monome/aleph-hardware/README.md

aleph-hardware
==============

http://monome.org/aleph

see license.txt
cc-by-sa

all circuit and board files created using cadsoft eagle.
