monome/aleph-hardware/aleph-bom.ods

 | aleph partlist
 | part number | supplier pn | supplier | qty required | comment | sch part
120 | ADSP-BF533SKSTZ-5V | ADSP-BF533SKSTZ-5V-ND | analog | 1 | dsp | DSP1
112 | AT32UC3A0512-ALTTA | AT32UC3A0512-ALTTA-ND | dk | 1 | controller | U15
112 | AD1939YSTZ | AD1939YSTZ-ND | dk | 1 | audio codec | U17
112 | MT48LC32M16A2TG-75:C TR | 557-1080-1-ND | dk | 1 | sdram for dsp | U23
112 | CY62157EV30LL-45ZXI | CY62157EV30LL-45ZXI | arrow | 1 | sram for controller | U16
1700 | AD8606ARZ | AD8606ARZ | avnet | 15 | audio opamp | IC2-IC13
112 | TPS2020D | 296-2560-5-ND | dk | 1 | controller host usb power switch | U4
112 | AD5686RARUZ | AD5686RARUZ-ND | dk | 1 | dac quad 16-bit, dsp cv out | U24
112 | AD7923BRUZ-REEL7 | AD7923BRUZ-REEL7CT-ND | avnet | 1 | adc quad cv controller | U21
112 | FDS9431A | FDS9431ACT-ND | ms | 1 | dsp power mosfet | U10
112 | LM2678SX-5.0/NOPB | LM2678SX-5.0/NOPBCT-ND | dk | 1 | main power regulator | U5
250 | ADP3339AKCZ-3.3-R7 | ADP3339AKCZ-3.3-R7CT-ND | dk | 2 | 3.3v regulator | U7, U9
112 | MSS1278-153ML_ | MSS1278-153ML_ | coilcraft | 1 | main power coil | L4
120 | SRR6038-100Y | SRR6038-100YCT-ND | dk | 1 | dsp power coil | L8
250 | MBRS360T3G | MBRS360T3GOSCT-ND | dk | 2 | main power diode | D13, D14
112 | ASFL1-27.000MHZ-L-T | 535-10820-2-ND | dk | 1 | dsp osc | Y1
112 | ASFL1-12.288MHZ-L-T | 535-10810-1-ND | dk | 1 | codec osc | Y3
112 | ECS-120-18-5PX-TR | XC1289CT-ND | ms | 1 | controller xtal | Y2
112 | LM4040D25IDBZR | 296-17940-1-ND | dk | 1 | controller ADC vref | U22
112 | ZHCS1000TA | ZHCS1000CT-ND | dk | 1 | dsp power diode | D2
112 | 2041021-3 | 35R2925 | tti | 1 | sdcard slot | S1
401 | EM14A0D-C24-L064N | EM14A0D-C24-L064N-ND | dk | 4 | encoder | E1-E4
110 | NHD-2.7-12864UCY3 | NHD-2.7-12864UCY3 | newhaven | 1 | oled screen
112 | SN74LVC2G14DBVR | 296-13010-1-ND | ms | 1 | inverter dual, debouncing | U26
112 | SN74AHCT14D | 296-1474-1-ND | avnet | 1 | inverter hex, debouncing | U25
112 | AD8567ARUZ-REEL | AD8567ARUZ-REELCT-ND | avnet | 1 | op amp, cv out gain | IC1
3000 | 1N4148W-TP | 833-1N4148W-TP | ms | 6 | diodes | D7-D12
112 | ATMEGA32U4-AUR | ATMEGA32U4-AURDKR-ND | dk | 1 | avr for usb-uart | U6
1000 | BAS70-04-E3-08 | BAS70-04-E3-08DKR-ND | ms | 6 | protection diodes | U1, U3, U11-U14
112 | LMR62014XMF/NOPB | LMR62014XMF/NOPBDKR-ND | dk | 1 | power boost converter, 12V system | U2
250 | MBR0520L-TP | MBR0520L-TPMSDKR-ND | dk | 1 | diode for 12V | D1
112 | EVQ-PNF04M | P13597SDKR-ND | ms | 1 | controller reset sw | SW1
112 | TPA6111A2DR | 296-10846-6-ND | ms | 1 | headphone amp | U8
120 | XAL7030-103 | XAL7030-103 | coilcraft | 1 | coil for 12V | L1
112 | NX5032GB-16MHZ-STD-CSK-5 | 644-1192-6-ND | dk | 1 | xtal for avr usb bridge | X1
500 | MMZ1608B601C | 445-2166-1-ND | dk | 4 | ADC filter | L6, L7, L9, L10
500 | LW Q38E-Q1S2-3K6L-1 | 475-2831-6-ND | ms | 5 | white led | LED3, LED4, LED6, LED8
350 | LTST-C170KRKT | 160-1415-6-ND | dk | 3 | red led | LED5, LED7, LED12
 | T491A475K016AT | 399-3697-2-ND | dk | 6 | cap 4.7u tant 1206
 | T491A106K010AT | 399-3684-2-ND | dk | 36 | cap 10u tant 1206
 | T491A226K010AT | 399-8280-2-ND | dk | 1 | cap 22u tant 1206
 | T491A476M006AT | 399-3700-1-ND | dk | 1 | cap 47u tant 1206
 | T491A686K006AT | 399-4698-2-ND | dk | 2 | cap 68u tant 1206
 | TAJB107M010RNJ | 478-5801-2-ND | dk | 2 | cap 100u tant 1210
 | T495C226K016ZTE350 | 495-1540-2-ND | dk | 1 | cap 22u tant 6032 (power in)
 | T495L107K010ZTE180 | 399-5193-2-ND | dk | 2 | cap 100u tant 7374 (power out)
 | C1608C0G1H080D080AA | 445-5043-2-ND | dk | 2 | cap 8p 0603
 | C1608C0G1H220J080AA | 445-1273-2-ND | dk | 2 | cap 22p 0603
 | C1608C0G1H101J080AA | 445-1281-2-ND | dk | 18 | cap 100p 0603
 | C0603C121J5GACTU | 399-1062-2-ND | dk | 8 | cap 120p 0603
 | CL10C221JB8NNNC | 1276-1048-2-ND | dk | 5 | cap 220p 0603
 | CL10C331JB8NNNC | 1276-1073-2-ND | dk | 4 | cap 330p 0603
 | CC0603KRX7R9BB391 | 311-1187-2-ND | dk | 1 | cap 390p 0603
 | CL10C471JB8NCNC | 1276-2302-2-ND | dk | 1 | cap 470p 0603
 | C1608X7R1H681K | 445-5077-2-ND | dk | 1 | cap 680p 0603
 | CL10B102KB8NNNC | 1276-1018-2-ND | dk | 8 | cap 1n 0603
 | CL10B222KB8SFNC | 1276-1992-2-ND | dk | 4 | cap 2.2n 0603
 | CL10B272KB8SFNC | 1276-2023-2-ND | dk | 5 | Cap 2.7n 0603
 | CL10B562KB8SFNC | 1276-2092-2-ND | dk | 1 | Cap 5.6n 0603
 | CL10B333KB8SFNC | 1276-2042-1-ND | dk | 11 | cap 33n 0603
 | CC0603ZRY5V9BB104 | 311-1343-2-ND | dk | 61 | cap 100n 0603
 | UMK107BJ105KA-T | 587-2400-2-ND | dk | 12 | cap 1u 0603
 | RC0603JR-070RL | 311-0.0GRTR-ND | dk | 15 | res 0 0603
 | RC0603JR-0722RL | 311-22GRTR-ND | dk | 3 | Res 22 0603
 | RC0603JR-0733RL | 311-33GRTR-ND | dk | 2 | Res 33 0603
 | RC0603JR-0739RL | 311-39GRTR-ND | dk | 2 | Res 39 0603
 | RC0603FR-07120RL | 311-120HRTR-ND | dk | 6 | Res 120 0603
 | RC0603FR-07150RL | 311-150HRTR-ND | dk | 4 | Res 150 0603
 | RC0603FR-07237RL | 311-237HRTR-ND | dk | 8 | Res 237 0603
 | RC0603FR-07270RL | 311-270HRTR-ND | dk | 8 | Res 270 0603
 | RC0603FR-07562RL | 311-562HRTR-ND | dk | 1 | Res 562 0603
 | RC0603FR-07604RL | 311-604HRTR-ND | dk | 4 | Res 604 0603
 | RC0603JR-071KL | 311-1.0KGRTR-ND | dk | 4 | Res 1.0k 0603
 | RC0603FR-071K65L | 311-1.65KHRTR-ND | dk | 4 | Res 1.65k 0603
 | RC0603FR-072K74L | 311-2.74KHRTR-ND | dk | 4 | Res 2.74k 0603
 | RC0603FR-073K32L | 311-3.32KHRTR-ND | dk | 5 | Res 3.32k 0603
 | RC0603JR-074K7L | 311-4.7KGRTR-ND | dk | 6 | Res 4.7k 0603
 | RC0603FR-075K49L | 311-5.49KHRTR-ND | dk | 8 | Res 5.49k 0603
 | RC0603FR-075K76L | 311-5.76KHRTR-ND | dk | 16 | Res 5.76k 0603 !
 | RC0603JR-0710KL | 311-10KGRTR-ND | dk | 28 | res 10k 0603 !
 | RC0603FR-0711KL | 311-11.0KHRTR-ND | dk | 4 | res 11k 0603
 | RC0603FR-0713K3L | 311-13.3KHRTR-ND | dk | 1 | Res 13.3k 0603
 | RC0603FR-0718KL | 311-18.0KHRTR-ND | dk | 15 | res 18k 0603
 | RC0603FR-0720KL | 311-20.0KHRTR-ND | dk | 2 | res 20k 0603
 | RC0603FR-0747KL | 311-47.0KHRTR-ND | dk | 7 | res 47k 0603
 | RC0603FR-0749K9L | 311-49.9KHRTR-ND | dk | 4 | Res 49.9k 0603
 | RC0603JR-0756KL | 311-56KGRTR-ND | dk | 2 | res 56k 0603
 | RC0603FR-07100KL | 311-100KHRTR-ND | dk | 17 | res 100k 0603
 | RC0603FR-07118KL | 311-118KHRTR-ND | dk | 1 | res 118k 0603
 | RC0603FR-07470KL | 311-470KHRTR-ND | dk | 5 | res 470k 0603
 | RC0603FR-07750KL | 311-750KHRTR-ND | dk | 4 | res 750k 0603
