monome/aleph-hardware/eagle/aleph.brd

## EAGLE design eagle/aleph.brd (2014-03-25)

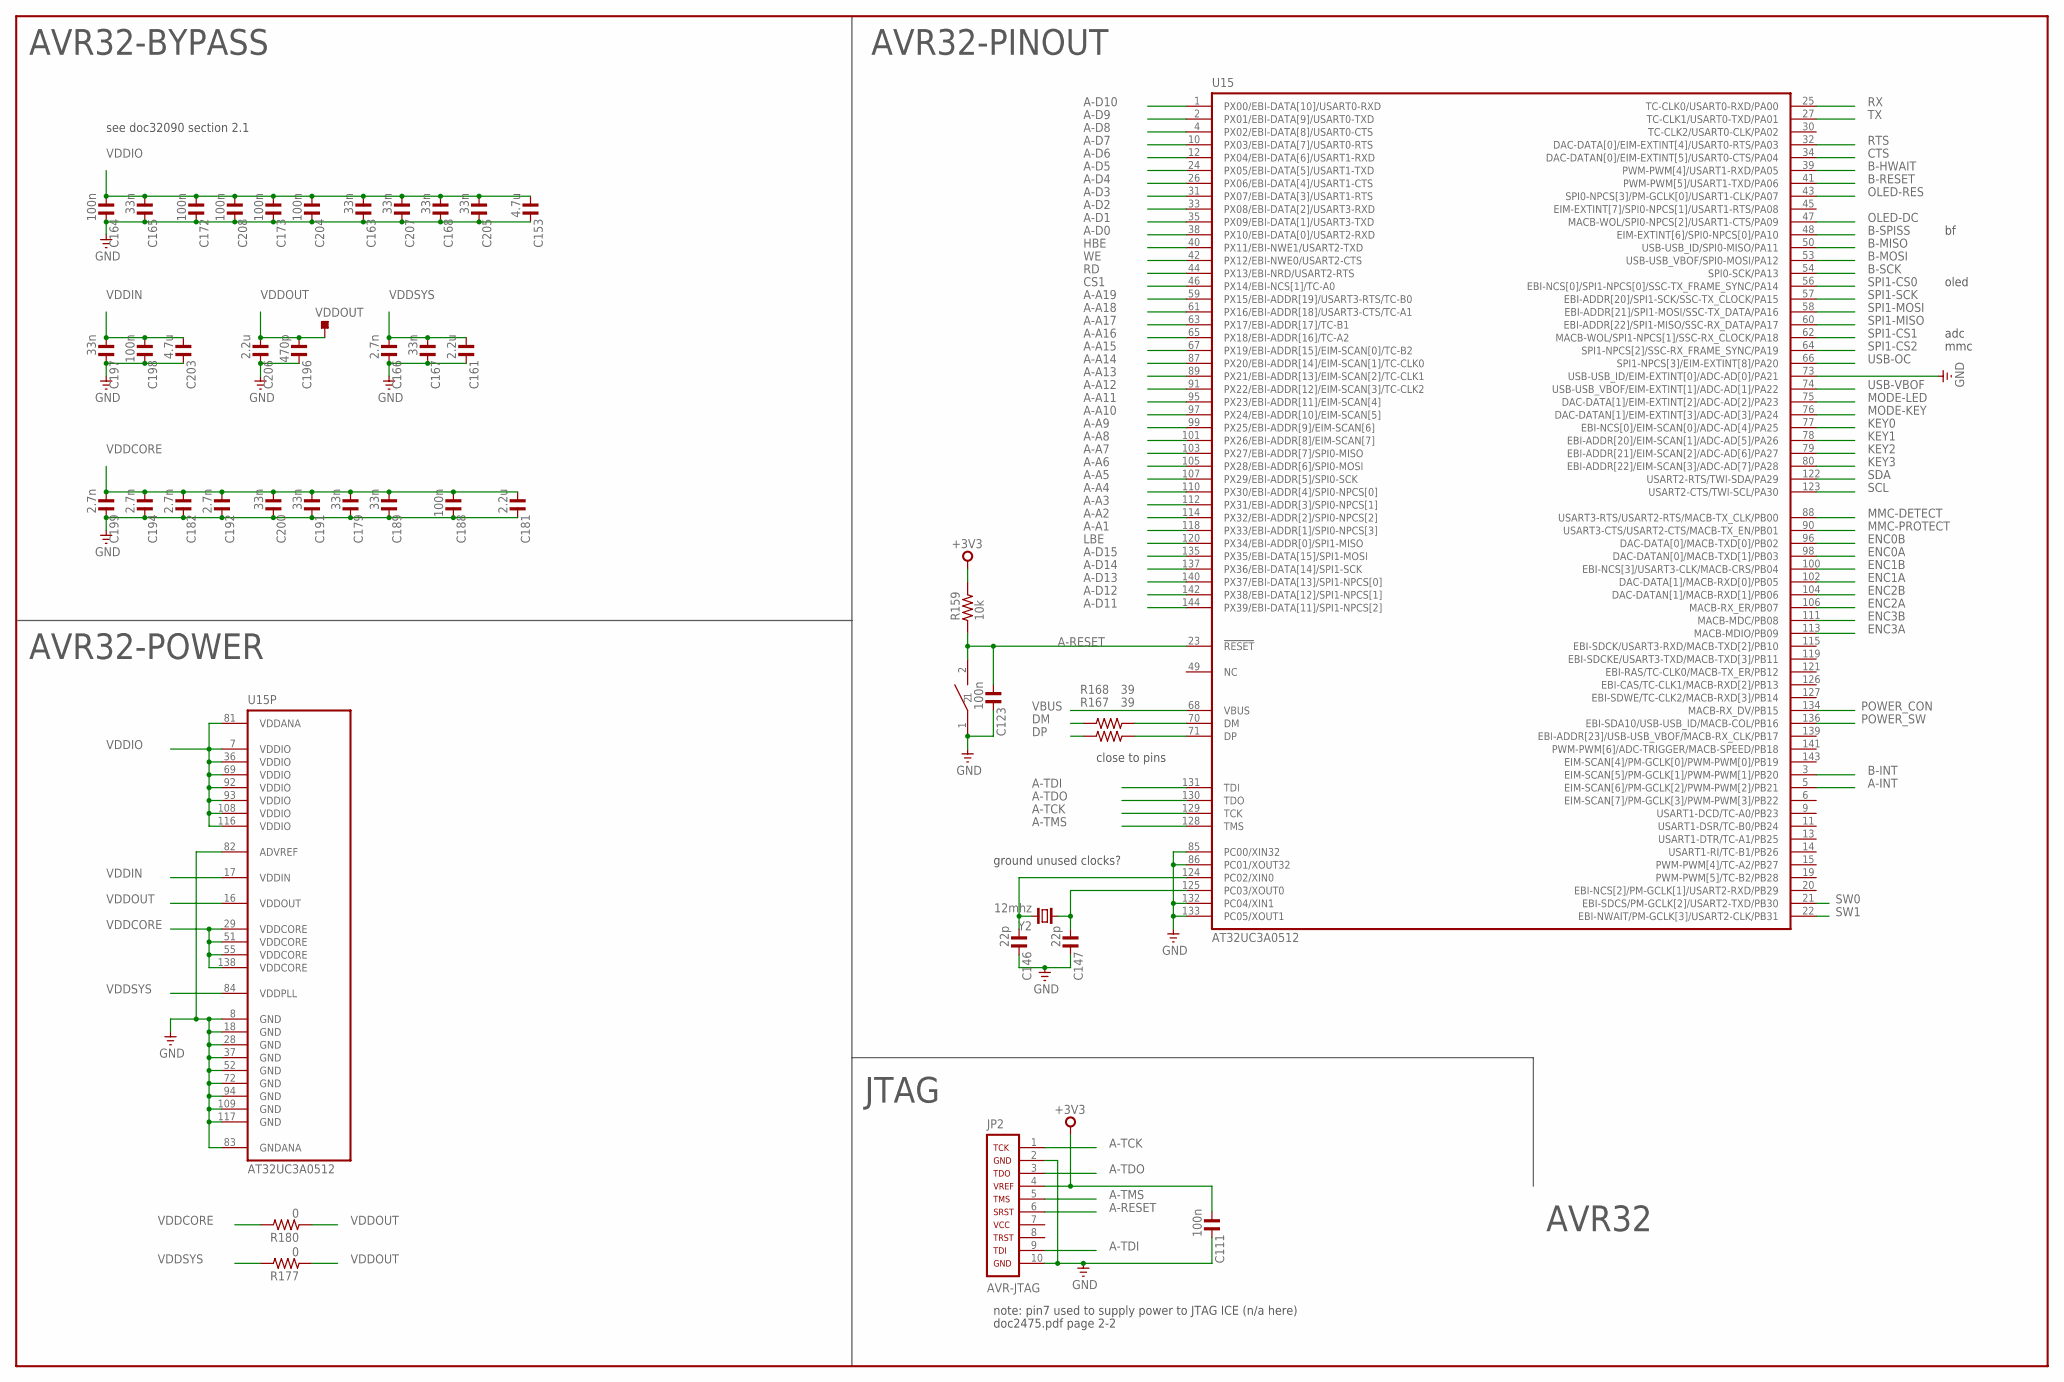
[picture p10: schematic aleph.sch, sheet 1]

Parts:
C111, C123, C164, C172, C173, C188, C198, C204, C208: 100n; C0603
C146, C147: 22p; C0603
C153, C203: 4.7u; C1206
C161, C181, C206: 2.2u; C1206
C163, C165, C167, C168, C179, C189, C191, C197, C200, C205, C207: 33n; C0603
C166, C182, C192, C194, C199: 2.7n; C0603
C196: 470p; C0603
JP2: AVR-JTAG; AVR-JTAG-10
R159: 10k; R0603
R167, R168: 39; R0603
R177, R180: 0; R0603
SW1: PANASONIC-EVQ
U15: AT32UC3A0512; LQFP144
VDDOUT: TPS-SMD-10R; SMD-10R
Y2: 12mhz; HC49UP

Connections:
+3V3: C111.1, JP2.4, R159.2; also elsewhere on the board
A-A1: U15.118 (PX33/EBI-ADDR[1]/SPI0-NPCS[3]); also elsewhere on the board
A-A2: U15.114 (PX32/EBI-ADDR[2]/SPI0-NPCS[2]); also elsewhere on the board
A-A3: U15.112 (PX31/EBI-ADDR[3]/SPI0-NPCS[1]); also elsewhere on the board
A-A4: U15.110 (PX30/EBI-ADDR[4]/SPI0-NPCS[0]); also elsewhere on the board
A-A5: U15.107 (PX29/EBI-ADDR[5]/SPI0-SCK); also elsewhere on the board
A-A6: U15.105 (PX28/EBI-ADDR[6]/SPI0-MOSI); also elsewhere on the board
A-A7: U15.103 (PX27/EBI-ADDR[7]/SPI0-MISO); also elsewhere on the board
A-A8: U15.101 (PX26/EBI-ADDR[8]/EIM-SCAN[7]); also elsewhere on the board
A-A9: U15.99 (PX25/EBI-ADDR[9]/EIM-SCAN[6]); also elsewhere on the board
A-A10: U15.97 (PX24/EBI-ADDR[10]/EIM-SCAN[5]); also elsewhere on the board
A-A11: U15.95 (PX23/EBI-ADDR[11]/EIM-SCAN[4]); also elsewhere on the board
A-A12: U15.91 (PX22/EBI-ADDR[12]/EIM-SCAN[3]/TC-CLK2); also elsewhere on the board
A-A13: U15.89 (PX21/EBI-ADDR[13]/EIM-SCAN[2]/TC-CLK1); also elsewhere on the board
A-A14: U15.87 (PX20/EBI-ADDR[14]/EIM-SCAN[1]/TC-CLK0); also elsewhere on the board
A-A15: U15.67 (PX19/EBI-ADDR[15]/EIM-SCAN[0]/TC-B2); also elsewhere on the board
A-A16: U15.65 (PX18/EBI-ADDR[16]/TC-A2); also elsewhere on the board
A-A17: U15.63 (PX17/EBI-ADDR[17]/TC-B1); also elsewhere on the board
A-A18: U15.61 (PX16/EBI-ADDR[18]/USART3-CTS/TC-A1); also elsewhere on the board
A-A19: U15.59 (PX15/EBI-ADDR[19]/USART3-RTS/TC-B0); also elsewhere on the board
A-D0: U15.38 (PX10/EBI-DATA[0]/USART2-RXD); also elsewhere on the board
A-D1: U15.35 (PX09/EBI-DATA[1]/USART3-TXD); also elsewhere on the board
A-D2: U15.33 (PX08/EBI-DATA[2]/USART3-RXD); also elsewhere on the board
A-D3: U15.31 (PX07/EBI-DATA[3]/USART1-RTS); also elsewhere on the board
A-D4: U15.26 (PX06/EBI-DATA[4]/USART1-CTS); also elsewhere on the board
A-D5: U15.24 (PX05/EBI-DATA[5]/USART1-TXD); also elsewhere on the board
A-D6: U15.12 (PX04/EBI-DATA[6]/USART1-RXD); also elsewhere on the board
A-D7: U15.10 (PX03/EBI-DATA[7]/USART0-RTS); also elsewhere on the board
A-D8: U15.4 (PX02/EBI-DATA[8]/USART0-CTS); also elsewhere on the board
A-D9: U15.2 (PX01/EBI-DATA[9]/USART0-TXD); also elsewhere on the board
A-D10: U15.1 (PX00/EBI-DATA[10]/USART0-RXD); also elsewhere on the board
A-D11: U15.144 (PX39/EBI-DATA[11]/SPI1-NPCS[2]); also elsewhere on the board
A-D12: U15.142 (PX38/EBI-DATA[12]/SPI1-NPCS[1]); also elsewhere on the board
A-D13: U15.140 (PX37/EBI-DATA[13]/SPI1-NPCS[0]); also elsewhere on the board
A-D14: U15.137 (PX36/EBI-DATA[14]/SPI1-SCK); also elsewhere on the board
A-D15: U15.135 (PX35/EBI-DATA[15]/SPI1-MOSI); also elsewhere on the board
A-INT: U15.5 (EIM-SCAN[6]/PM-GCLK[2]/PWM-PWM[2]/PB21); also elsewhere on the board
A-RESET: C123.1, JP2.6, R159.1, SW1.2, U15.23 (!RESET)
A-TCK: JP2.1, U15.129 (TCK)
A-TDI: JP2.9, U15.131 (TDI)
A-TDO: JP2.3, U15.130 (TDO)
A-TMS: JP2.5, U15.128 (TMS)
B-HWAIT: U15.39 (PWM-PWM[4]/USART1-RXD/PA05); also elsewhere on the board
B-INT: U15.3 (EIM-SCAN[5]/PM-GCLK[1]/PWM-PWM[1]/PB20); also elsewhere on the board
B-MISO: U15.50 (USB-USB_ID/SPI0-MISO/PA11); also elsewhere on the board
B-MOSI: U15.53 (USB-USB_VBOF/SPI0-MOSI/PA12); also elsewhere on the board
B-RESET: U15.41 (PWM-PWM[5]/USART1-TXD/PA06); also elsewhere on the board
B-SCK: U15.54 (SPI0-SCK/PA13); also elsewhere on the board
B-SPISS: U15.48 (EIM-EXTINT[6]/SPI0-NPCS[0]/PA10); also elsewhere on the board
CS1: U15.46 (PX14/EBI-NCS[1]/TC-A0); also elsewhere on the board
CTS: U15.34 (DAC-DATAN[0]/EIM-EXTINT[5]/USART0-CTS/P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); also elsewhere on the board
DM: R168.2; also elsewhere on the board
DP: R167.2; also elsewhere on the board
ENC0A: U15.98 (DAC-DATAN[0]/MACB-TXD[1]/PB03); also elsewhere on the board
ENC0B: U15.96 (DAC-DATA[0]/MACB-TXD[0]/PB02); also elsewhere on the board
ENC1A: U15.102 (DAC-DATA[1]/MACB-RXD[0]/PB05); also elsewhere on the board
ENC1B: U15.100 (EBI-NCS[3]/USART3-CLK/MACB-CRS/PB04); also elsewhere on the board
ENC2A: U15.106 (MACB-RX_ER/PB07); also elsewhere on the board
ENC2B: U15.104 (DAC-DATAN[1]/MACB-RXD[1]/PB06); also elsewhere on the board
ENC3A: U15.113 (MACB-MDIO/PB09); also elsewhere on the board
ENC3B: U15.111 (MACB-MDC/PB08); also elsewhere on the board
GND: C111.2, C123.2, C146.2, C147.2, C153.2, C161.2, C163.2, C164.2, C165.2, C166.2, C167.2, C168.2, C172.2, C173.2, C179.2, C181.2, C182.2, C188.2, C189.2, C191.2, C192.2, C194.2, C196.2, C197.2, C198.2, C199.2, C200.2, C203.2, C204.2, C205.2, C206.2, C207.2, C208.2, JP2.2, JP2.10, SW1.1, U15.8 (GND), U15.18 (GND), U15.28 (GND), U15.37 (GND), U15.52 (GND), U15.72 (GND), U15.73 (USB-USB_ID/EIM-EXTINT[0]/ADC-AD[0]/PA21), U15.82 (ADVREF), U15.83 (GNDANA), U15.85 (PC00/XIN32), U15.86 (PC01/XOUT32), U15.94 (GND), U15.109 (GND), U15.117 (GND), U15.132 (PC04/XIN1), U15.133 (PC05/XOUT1); also elsewhere on the board
HBE: U15.40 (PX11/EBI-NWE1/USART2-TXD); also elsewhere on the board
KEY0: U15.77 (EBI-NCS[0]/EIM-SCAN[0]/ADC-AD[4]/PA25); also elsewhere on the board
KEY1: U15.78 (EBI-ADDR[20]/EIM-SCAN[1]/ADC-AD[5]/PA26); also elsewhere on the board
KEY2: U15.79 (EBI-ADDR[21]/EIM-SCAN[2]/ADC-AD[6]/PA27); also elsewhere on the board
KEY3: U15.80 (EBI-ADDR[22]/EIM-SCAN[3]/ADC-AD[7]/PA28); also elsewhere on the board
LBE: U15.120 (PX34/EBI-ADDR[0]/SPI1-MISO); also elsewhere on the board
MMC-DETECT: U15.88 (USART3-RTS/USART2-RTS/MACB-TX_CLK/PB00); also elsewhere on the board
MMC-PROTECT: U15.90 (USART3-CTS/USART2-CTS/MACB-TX_EN/PB01); also elsewhere on the board
MODE-KEY: U15.76 (DAC-DATAN[1]/EIM-EXTINT[3]/ADC-AD[3]/PA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); also elsewhere on the board
MODE-LED: U15.75 (DAC-DATA[1]/EIM-EXTINT[2]/ADC-AD[2]/PA23); also elsewhere on the board
unnamed: C146.1, U15.124 (PC02/XIN0), Y2.2
unnamed: C147.1, U15.125 (PC03/XOUT0), Y2.1
unnamed: R168.1, U15.70 (DM)
unnamed: R167.1, U15.71 (DP)
OLED-DC: U15.47 (MACB-WOL/SPI0-NPCS[2]/USART1-CTS/PA09); also elsewhere on the board
OLED-RES: U15.43 (SPI0-NPCS[3]/PM-GCLK[0]/USART1-CLK/PA07); also elsewhere on the board
POWER_CON: U15.134 (MACB-RX_DV/PB15); also elsewhere on the board
POWER_SW: U15.136 (EBI-SDA10/USB-USB_ID/MACB-COL/PB16); also elsewhere on the board
RD: U15.44 (PX13/EBI-NRD/USART2-RTS); also elsewhere on the board
RTS: U15.32 (DAC-DATA[0]/EIM-EXTINT[4]/USART0-RTS/PA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); also elsewhere on the board
RX: U15.25 (TC-CLK0/USART0-RXD/PA00); also elsewhere on the board
SCL: U15.123 (USART2-CTS/TWI-SCL/PA30); also elsewhere on the board
SDA: U15.122 (USART2-RTS/TWI-SDA/PA29); also elsewhere on the board
SPI1-CS0: U15.56 (EBI-NCS[0]/SPI1-NPCS[0]/SSC-TX_FRAME_SY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); also elsewhere on the board
SPI1-CS1: U15.62 (MACB-WOL/SPI1-NPCS[1]/SSC-RX_CLOCK/PA18); also elsewhere on the board
SPI1-CS2: U15.64 (SPI1-NPCS[2]/SSC-RX_FRAME_SYNC/PA19); also elsewhere on the board
SPI1-MISO: U15.60 (EBI-ADDR[22]/SPI1-MISO/SSC-RX_DATA/PA17); also elsewhere on the board
SPI1-MOSI: U15.58 (EBI-ADDR[21]/SPI1-MOSI/SSC-TX_DATA/PA16); also elsewhere on the board
SPI1-SCK: U15.57 (EBI-ADDR[20]/SPI1-SCK/SSC-TX_CLOCK/PA15); also elsewhere on the board
SW0: U15.21 (EBI-SDCS/PM-GCLK[2]/USART2-TXD/PB30); also elsewhere on the board
SW1: U15.22 (EBI-NWAIT/PM-GCLK[3]/USART2-CLK/PB31); also elsewhere on the board
TX: U15.27 (TC-CLK1/USART0-TXD/PA01); also elsewhere on the board
USB-OC: U15.66 (SPI1-NPCS[3]/EIM-EXTINT[8]/PA20); also elsewhere on the board
USB-VBOF: U15.74 (USB-USB_VBOF/EIM-EXTINT[1]/ADC-AD[1]/PA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); also elsewhere on the board
VBUS: U15.68 (VBUS); also elsewhere on the board
VDDCORE: C179.1, C181.1, C182.1, C188.1, C189.1, C191.1, C192.1, C194.1, C199.1, C200.1, R180.2, U15.29 (VDDCORE), U15.51 (VDDCORE), U15.55 (VDDCORE), U15.138 (VDDCORE)
VDDIN: C197.1, C198.1, C203.1, U15.17 (VDDIN); also elsewhere on the board
VDDIO: C153.1, C163.1, C164.1, C165.1, C168.1, C172.1, C173.1, C204.1, C205.1, C207.1, C208.1, U15.7 (VDDIO), U15.36 (VDDIO), U15.69 (VDDIO), U15.81 (VDDANA), U15.92 (VDDIO), U15.93 (VDDIO), U15.108 (VDDIO), U15.116 (VDDIO); also elsewhere on the board
VDDOUT: C196.1, C206.1, R177.1, R180.1, U15.16 (VDDOUT), VDDOUT.TP
VDDSYS: C161.1, C166.1, C167.1, R177.2, U15.84 (VDDPLL)
WE: U15.42 (PX12/EBI-NWE0/USART2-CTS); also elsewhere on the board

Notes on the sheet:
note: pin7 used to supply power to JTAG ICE (n/a here)
doc2475.pdf page 2-2
ground unused clocks?
close to pins
see doc32090 section 2.1
mmc
adc
JTAG
AVR32-POWER
AVR32-BYPASS
AVR32-PINOUT
oled
AVR32

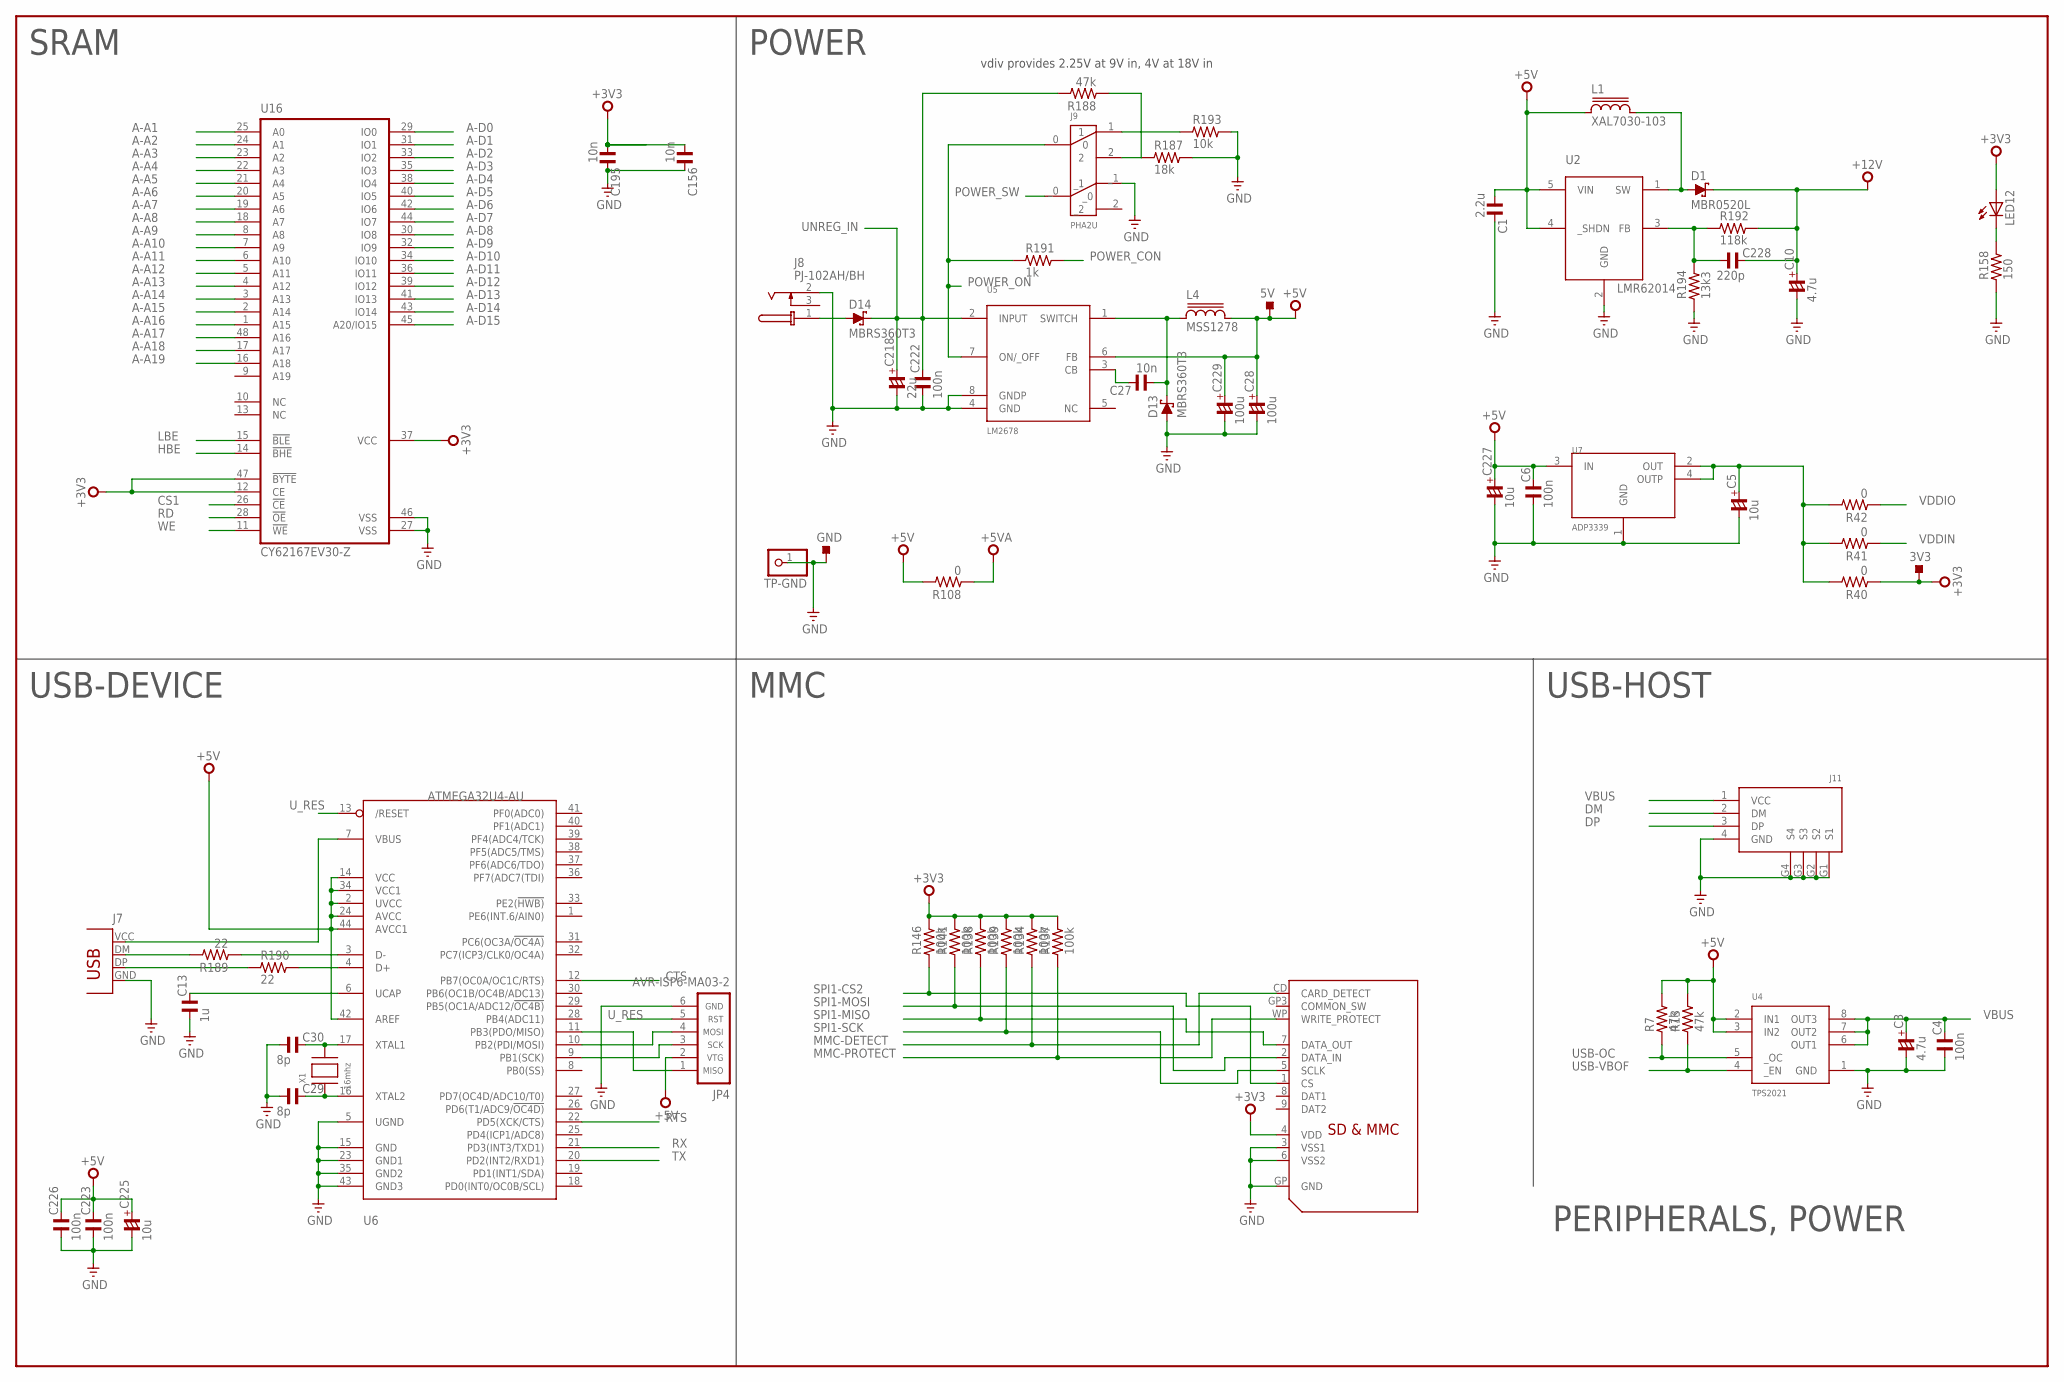
[picture p11: schematic aleph.sch, sheet 2]

Parts:
3V3, 5V: TPS-SMD-15R; SMD-15R
C1: 2.2u; C1206
C3, C10: 4.7u; C1206/T
C4, C223, C226: 100n; C0603
C5, C225, C227: 10u; C1206/T
C6, C222: 100n; C1206
C13: 1u; C0603
C27, C156, C195: 10n; C0603
C28, C229: 100u; C7343-43
C29, C30: 8p; C0603
C218: 22u; C6032-28/T
C228: 220p; C0603
D1: MBR0520L; SOD123
D13, D14: MBRS360T3; SMC
GND: TPS-SMD-20R; SMD-20R
J7: USB_TYPE_B; USB_B
J8: PJ-102AH/BH; PJ-102XH
J9: PHA2U
J11: USBA-VERT
JP4: AVR-ISP6-MA03-2; HDR-MA03-2
L1: XAL7030-103
L4: MSS1278
LED12: LEDCHIPLED_0805; CHIPLED_0805
R7, R13, R188: 47k; R0603
R40, R41, R42, R108: 0; R0603
R134, R137, R138, R139, R141, R146: 100k; R0603
R158: 150; R0603
R187: 18k; R0603
R189, R190: 22; R0603
R191: 1k; R0603
R192: 118k; R0603
R193: 10k; R0603
R194: 13k3; R0603
S1: SDMMC06132; 06132
TP-GND: PINHD-1X1; 1X01
U2: LMR62014; SOT23-5
U4: TPS2021; SO08
U5: LM2678; TO263-7
U6: ATMEGA32U4-AU; TQFP44
U7: ADP3339; SOT223
U16: CY62167EV30-Z; TSOP48
X1: 16mhz; NX5032

Connections:
+3V3: 3V3.TP, C156.1, C195.1, LED12.A, R40.1, R134.2, R137.2, R138.2, R139.2, R141.2, R146.2, S1.4 (VDD), U16.12 (CE), U16.37 (VCC), U16.47 (!BYTE!); also elsewhere on the board
+5V: 5V.TP, C1.1, C6.2, C28.+, C223.2, C225.+, C226.2, C227.+, C229.+, JP4.2, L1.P$1 (1), L4.2, R7.2, R13.2, R108.2, U2.4 (_SHDN), U2.5 (VIN), U4.2 (IN1), U4.3 (IN2), U5.6 (FB), U6.2 (UVCC), U6.14 (VCC), U6.24 (AVCC), U6.34 (VCC1), U6.42 (AREF), U6.44 (AVCC1), U7.3 (IN); also elsewhere on the board
+5VA: R108.1; also elsewhere on the board
+12V: C10.+, C228.2, D1.C, R192.2; also elsewhere on the board
A-A1: U16.25 (A0); also elsewhere on the board
A-A2: U16.24 (A1); also elsewhere on the board
A-A3: U16.23 (A2); also elsewhere on the board
A-A4: U16.22 (A3); also elsewhere on the board
A-A5: U16.21 (A4); also elsewhere on the board
A-A6: U16.20 (A5); also elsewhere on the board
A-A7: U16.19 (A6); also elsewhere on the board
A-A8: U16.18 (A7); also elsewhere on the board
A-A9: U16.8 (A8); also elsewhere on the board
A-A10: U16.7 (A9); also elsewhere on the board
A-A11: U16.6 (A10); also elsewhere on the board
A-A12: U16.5 (A11); also elsewhere on the board
A-A13: U16.4 (A12); also elsewhere on the board
A-A14: U16.3 (A13); also elsewhere on the board
A-A15: U16.2 (A14); also elsewhere on the board
A-A16: U16.1 (A15); also elsewhere on the board
A-A17: U16.48 (A16); also elsewhere on the board
A-A18: U16.17 (A17); also elsewhere on the board
A-A19: U16.16 (A18); also elsewhere on the board
A-D0: U16.29 (IO0); also elsewhere on the board
A-D1: U16.31 (IO1); also elsewhere on the board
A-D2: U16.33 (IO2); also elsewhere on the board
A-D3: U16.35 (IO3); also elsewhere on the board
A-D4: U16.38 (IO4); also elsewhere on the board
A-D5: U16.40 (IO5); also elsewhere on the board
A-D6: U16.42 (IO6); also elsewhere on the board
A-D7: U16.44 (IO7); also elsewhere on the board
A-D8: U16.30 (IO8); also elsewhere on the board
A-D9: U16.32 (IO9); also elsewhere on the board
A-D10: U16.34 (IO10); also elsewhere on the board
A-D11: U16.36 (IO11); also elsewhere on the board
A-D12: U16.39 (IO12); also elsewhere on the board
A-D13: U16.41 (IO13); also elsewhere on the board
A-D14: U16.43 (IO14); also elsewhere on the board
A-D15: U16.45 (A20/IO15); also elsewhere on the board
CS1: U16.26 (!CE!); also elsewhere on the board
CTS: U6.12 (PB7(OC0A/OC1C/RTS)); also elsewhere on the board
DM: J11.2 (DM); also elsewhere on the board
DP: J11.3 (DP); also elsewhere on the board
GND: C1.2, C3.-, C4.1, C5.-, C6.1, C10.-, C13.1, C28.-, C29.1, C30.1, C156.2, C195.2, C218.-, C222.1, C223.1, C225.-, C226.1, C227.-, C229.-, D13.A, GND.TP, J7.GND, J8.2 (S), J9._1, J11.4 (GND), J11.G1 (S1), J11.G2 (S2), J11.G3 (S3), J11.G4 (S4), JP4.6, R158.1, R187.2, R193.2, R194.1, S1.3 (VSS1), S1.6 (VSS2), S1.GP (GND), TP-GND.1, U2.2 (GND), U4.1 (GND), U5.4 (GND), U5.8 (GNDP), U6.5 (UGND), U6.15 (GND), U6.23 (GND1), U6.35 (GND2), U6.43 (GND3), U7.1 (GND), U16.27 (VSS), U16.46 (VSS); also elsewhere on the board
HBE: U16.14 (!BHE!); also elsewhere on the board
LBE: U16.15 (!BLE!); also elsewhere on the board
MMC-DETECT: R134.1, S1.CD (CARD_DETECT); also elsewhere on the board
MMC-PROTECT: R137.1, S1.WP (WRITE_PROTECT); also elsewhere on the board
unnamed: D14.A, J8.1 (T)
unnamed: J7.DM (USBDM), R189.2
unnamed: C27.1, D13.C, L4.1, U5.1 (SWITCH)
unnamed: C27.2, U5.3 (CB)
unnamed: J7.DP (USBDP), R190.1
unnamed: R190.2, U6.4 (D+)
unnamed: LED12.C, R158.2
unnamed: R189.1, U6.3 (D-)
unnamed: C5.+, R40.2, R41.2, R42.2, U7.2 (OUT), U7.4 (OUTP)
unnamed: J9.1, R193.1
unnamed: J9.2, R187.1, R188.1
unnamed: C29.2, U6.16 (XTAL2), X1.P$1
unnamed: C30.2, U6.17 (XTAL1), X1.P$2
unnamed: D1.A, L1.P$2 (2), U2.1 (SW)
unnamed: C228.1, R192.1, R194.2, U2.3 (FB)
unnamed: C13.2, U6.6 (UCAP)
unnamed: J7.VCC, U6.7 (VBUS)
POWER_CON: R191.2; also elsewhere on the board
POWER_ON: J9.0, R191.1, U5.7 (ON/_OFF)
POWER_SW: J9._0; also elsewhere on the board
RD: U16.28 (!OE!); also elsewhere on the board
RTS: U6.22 (PD5(XCK/CTS)); also elsewhere on the board
RX: U6.21 (PD3(INT3/TXD1)); also elsewhere on the board
SPI1-CS2: R146.1, S1.1 (CS); also elsewhere on the board
SPI1-MISO: R138.1, S1.7 (DATA_OUT); also elsewhere on the board
SPI1-MOSI: R141.1, S1.2 (DATA_IN); also elsewhere on the board
SPI1-SCK: R139.1, S1.5 (SCLK); also elsewhere on the board
TX: U6.20 (PD2(INT2/RXD1)); also elsewhere on the board
U-MISO: JP4.1, U6.11 (PB3(PDO/MISO))
U-MOSI: JP4.4, U6.10 (PB2(PDI/MOSI))
U-SCK: JP4.3, U6.9 (PB1(SCK))
UNREG_IN: C218.+, C222.2, D14.C, R188.2, U5.2 (INPUT)
USB-OC: R7.1, U4.5 (_OC); also elsewhere on the board
USB-VBOF: R13.1, U4.4 (_EN); also elsewhere on the board
U_RES: JP4.5, U6.13 (/RESET)
VBUS: C3.+, C4.2, J11.1 (VCC), U4.6 (OUT1), U4.7 (OUT2), U4.8 (OUT3); also elsewhere on the board
VDDIN: R41.1; also elsewhere on the board
VDDIO: R42.1; also elsewhere on the board
WE: U16.11 (!WE!); also elsewhere on the board

Notes on the sheet:
SRAM
MMC
USB-HOST
USB-DEVICE
vdiv provides 2.25V at 9V in, 4V at 18V in
POWER
PERIPHERALS, POWER

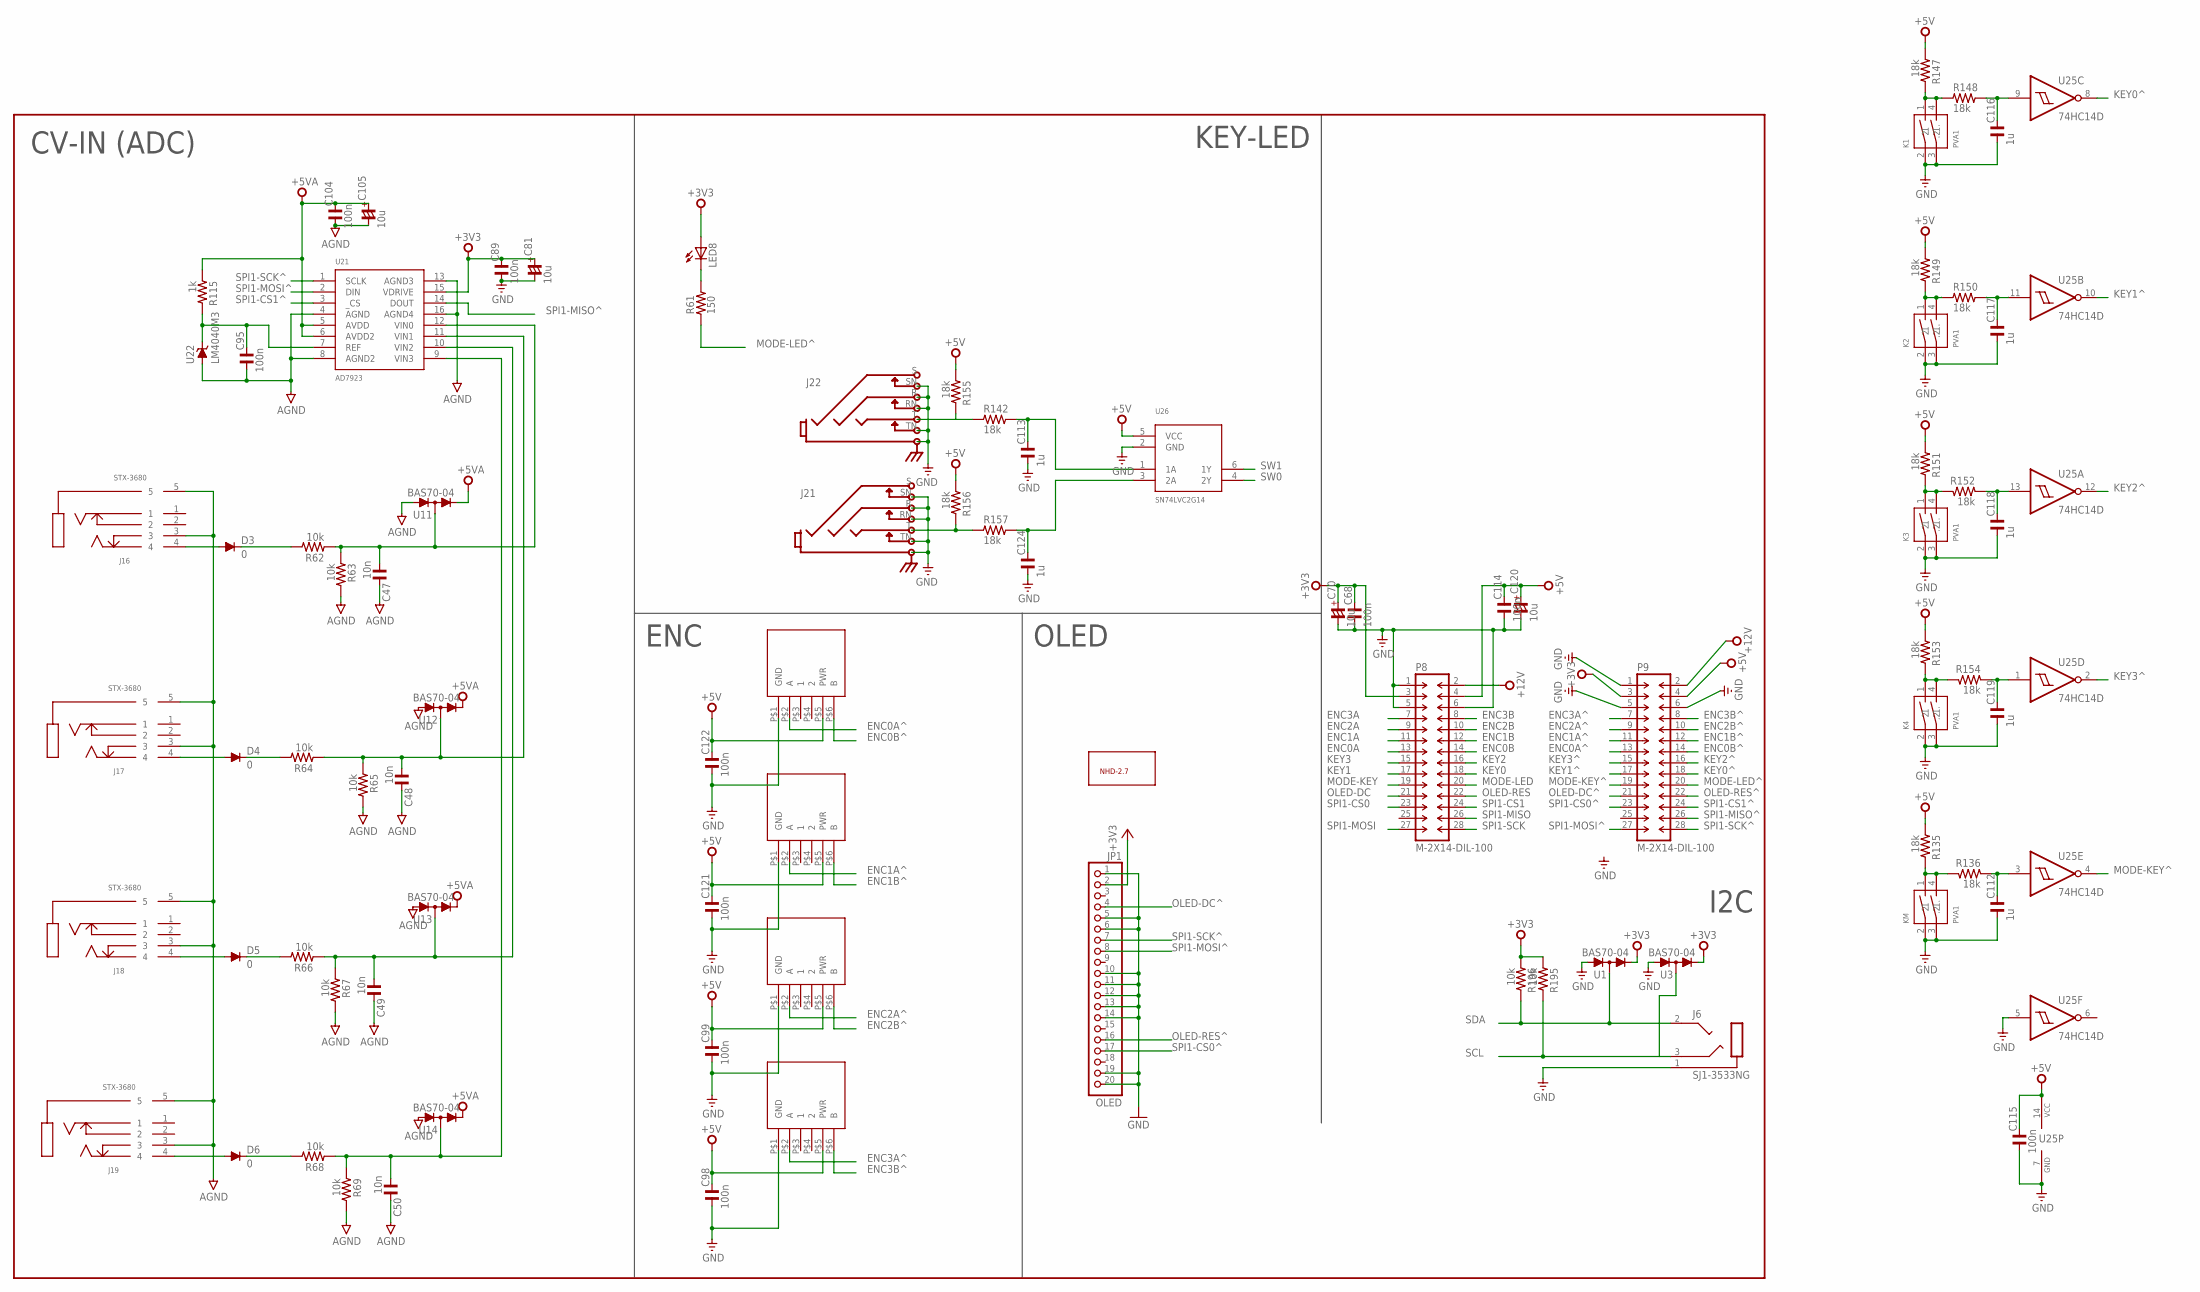
[picture p12: schematic aleph.sch, sheet 3]

Parts:
C47, C48, C49, C50: 10n; C0603
C68, C89, C95, C98, C99, C104, C114, C115, C121, C122: 100n; C0603
C70, C81, C105, C120: 10u; C1206/T
C112, C113, C116, C117, C118, C119, C124: 1u; C0603
D3, D4, D5, D6: 0; SOD123
E1, E2, E3, E4: BOURNS-EM14
J6: SJ1-3533NG
J16, J17, J18, J19: STX-3680
J21, J22: STEREOSW3GND; NEUTRIK-NRJ6HF-1
JP1: OLED; 1X20
K1, K2, K3, K4: PVA1
KM: PVA1
LED8: LEDCHIPLED_0805; CHIPLED_0805
P8, P9: M-2X14-DIL-100; DIL-100-2X14
R61: 150; R0603
R62, R63, R64, R65, R66, R67, R68, R69, R195, R196: 10k; R0603
R115: 1k; R0603
R135, R136, R142, R147, R148, R149, R150, R151, R152, R153, R154, R155, R156, R157: 18k; R0603
REF-OLED: NHD-2.7
U1, U3, U11, U12, U13, U14: BAS70-04; SOT23
U21: AD7923; TSSOP16
U22: LM4040M3; SOT23
U25: 74HC14D; SO14
U26: SN74LVC2G14; SOT23-6

Connections:
+3V3: C68.2, C70.+, C81.+, C89.2, JP1.2, LED8.A, P8.3, P9.3, R195.1, R196.1, U1.2 (C), U3.2 (C), U21.15 (VDRIVE); also elsewhere on the board
+5V: C98.2, C99.2, C114.2, C115.2, C120.+, C121.2, C122.2, E1.P$5 (PWR), E2.P$5 (PWR), E3.P$5 (PWR), E4.P$5 (PWR), P8.4, P9.4, R135.1, R147.1, R149.1, R151.1, R153.1, R155.1, R156.1, U25.14 (VCC), U26.5 (VCC); also elsewhere on the board
+5VA: C104.2, C105.+, R115.1, U11.2 (C), U12.2 (C), U13.2 (C), U14.2 (C), U21.5 (AVDD), U21.6 (AVDD2); also elsewhere on the board
+12V: P8.2, P9.2; also elsewhere on the board
AGND: C47.2, C48.2, C49.2, C50.2, C95.1, C104.1, C105.-, J16.3, J16.5, J17.3, J17.5, J18.3, J18.5, J19.3, J19.5, R63.2, R65.2, R67.2, R69.2, U11.1 (A), U12.1 (A), U13.1 (A), U14.1 (A), U21.4 (AGND), U21.8 (AGND2), U21.13 (AGND3), U21.16 (AGND4), U22.2 (A); also elsewhere on the board
ENC0A: P8.13; also elsewhere on the board
ENC0A^: E1.P$2 (A), P9.13
ENC0B: P8.14; also elsewhere on the board
ENC0B^: E1.P$6 (B), P9.14
ENC1A: P8.11; also elsewhere on the board
ENC1A^: E2.P$2 (A), P9.11
ENC1B: P8.12; also elsewhere on the board
ENC1B^: E2.P$6 (B), P9.12
ENC2A: P8.9; also elsewhere on the board
ENC2A^: E4.P$2 (A), P9.9
ENC2B: P8.10; also elsewhere on the board
ENC2B^: E4.P$6 (B), P9.10
ENC3A: P8.7; also elsewhere on the board
ENC3A^: E3.P$2 (A), P9.7
ENC3B: P8.8; also elsewhere on the board
ENC3B^: E3.P$6 (B), P9.8
GND: C68.1, C70.-, C81.-, C89.1, C98.1, C99.1, C112.1, C113.1, C114.1, C115.1, C116.1, C117.1, C118.1, C119.1, C120.-, C121.1, C122.1, C124.1, E1.P$1 (GND), E2.P$1 (GND), E3.P$1 (GND), E4.P$1 (GND), J6.1 (S), J21.R, J21.RN, J21.SN, J21.TN, J22.R, J22.RN, J22.SN, J22.TN, JP1.1, JP1.5, JP1.6, JP1.10, JP1.11, JP1.12, JP1.13, JP1.14, JP1.19, JP1.20, K1.2 (1), K1.3 (1.), K2.2 (1), K2.3 (1.), K3.2 (1), K3.3 (1.), K4.2 (1), K4.3 (1.), KM.2 (1), KM.3 (1.), P8.1, P8.5, P8.6, P9.1, P9.5, P9.6, U1.1 (A), U3.1 (A), U25.5 (I), U25.7 (GND), U26.2 (GND); also elsewhere on the board
KEY0: P8.18; also elsewhere on the board
KEY0^: P9.18, U25.8 (O)
KEY1: P8.17; also elsewhere on the board
KEY1^: P9.17, U25.10 (O)
KEY2: P8.16; also elsewhere on the board
KEY2^: P9.16, U25.12 (O)
KEY3: P8.15; also elsewhere on the board
KEY3^: P9.15, U25.2 (O)
MODE-KEY: P8.19; also elsewhere on the board
MODE-KEY^: P9.19, U25.4 (O)
MODE-LED: P8.20; also elsewhere on the board
MODE-LED^: P9.20, R61.1
unnamed: K1.1 (2), K1.4 (.2), R147.2, R148.1
unnamed: C116.2, R148.2, U25.9 (I)
unnamed: K2.1 (2), K2.4 (.2), R149.2, R150.1
unnamed: C117.2, R150.2, U25.11 (I)
unnamed: LED8.C, R61.2
unnamed: K3.1 (2), K3.4 (.2), R151.2, R152.2
unnamed: C118.2, R152.1, U25.13 (I)
unnamed: K4.1 (2), K4.4 (.2), R153.2, R154.2
unnamed: C119.2, R154.1, U25.1 (I)
unnamed: D3.A, J16.4
unnamed: D4.C, R64.2
unnamed: D3.C, R62.2
unnamed: D5.C, R66.2
unnamed: D4.A, J17.4
unnamed: KM.1 (2), KM.4 (.2), R135.2, R136.2
unnamed: D6.C, R68.2
unnamed: D5.A, J18.4
unnamed: C112.2, R136.1, U25.3 (I)
unnamed: D6.A, J19.4
unnamed: C124.2, R157.2, U26.3 (2A)
unnamed: C95.2, R115.2, U21.7 (REF), U22.1 (C)
unnamed: C48.1, R64.1, R65.1, U12.3 (AC), U21.11 (VIN1)
unnamed: C49.1, R66.1, R67.1, U13.3 (AC), U21.10 (VIN2)
unnamed: C50.1, R68.1, R69.1, U14.3 (AC), U21.9 (VIN3)
unnamed: C47.1, R62.1, R63.1, U11.3 (AC), U21.12 (VIN0)
unnamed: C113.2, R142.2, U26.1 (1A)
OLED-DC: P8.21; also elsewhere on the board
OLED-DC^: JP1.4, P9.21
OLED-RES: P8.22; also elsewhere on the board
OLED-RES^: JP1.16, P9.22
SCL: J6.3 (R), R195.2, U3.3 (AC); also elsewhere on the board
SDA: J6.2 (T), R196.2, U1.3 (AC); also elsewhere on the board
SPI1-CS0: P8.23; also elsewhere on the board
SPI1-CS0^: JP1.17, P9.23
SPI1-CS1: P8.24; also elsewhere on the board
SPI1-CS1^: P9.24, U21.3 (_CS)
SPI1-MISO: P8.26; also elsewhere on the board
SPI1-MISO^: P9.26, U21.14 (DOUT)
SPI1-MOSI: P8.27; also elsewhere on the board
SPI1-MOSI^: JP1.8, P9.27, U21.2 (DIN)
SPI1-SCK: P8.28; also elsewhere on the board
SPI1-SCK^: JP1.7, P9.28, U21.1 (SCLK)
SW0: U26.4 (2Y); also elsewhere on the board
SW0CON^: J22.T, R142.1, R155.2
SW1: U26.6 (1Y); also elsewhere on the board
SW1CON^: J21.T, R156.2, R157.1

Notes on the sheet:
I2C
OLED
KEY-LED
CV-IN (ADC)
ENC
