monome/aleph-hardware/eagle/aleph.brd

## EAGLE design eagle/aleph.brd (continued)

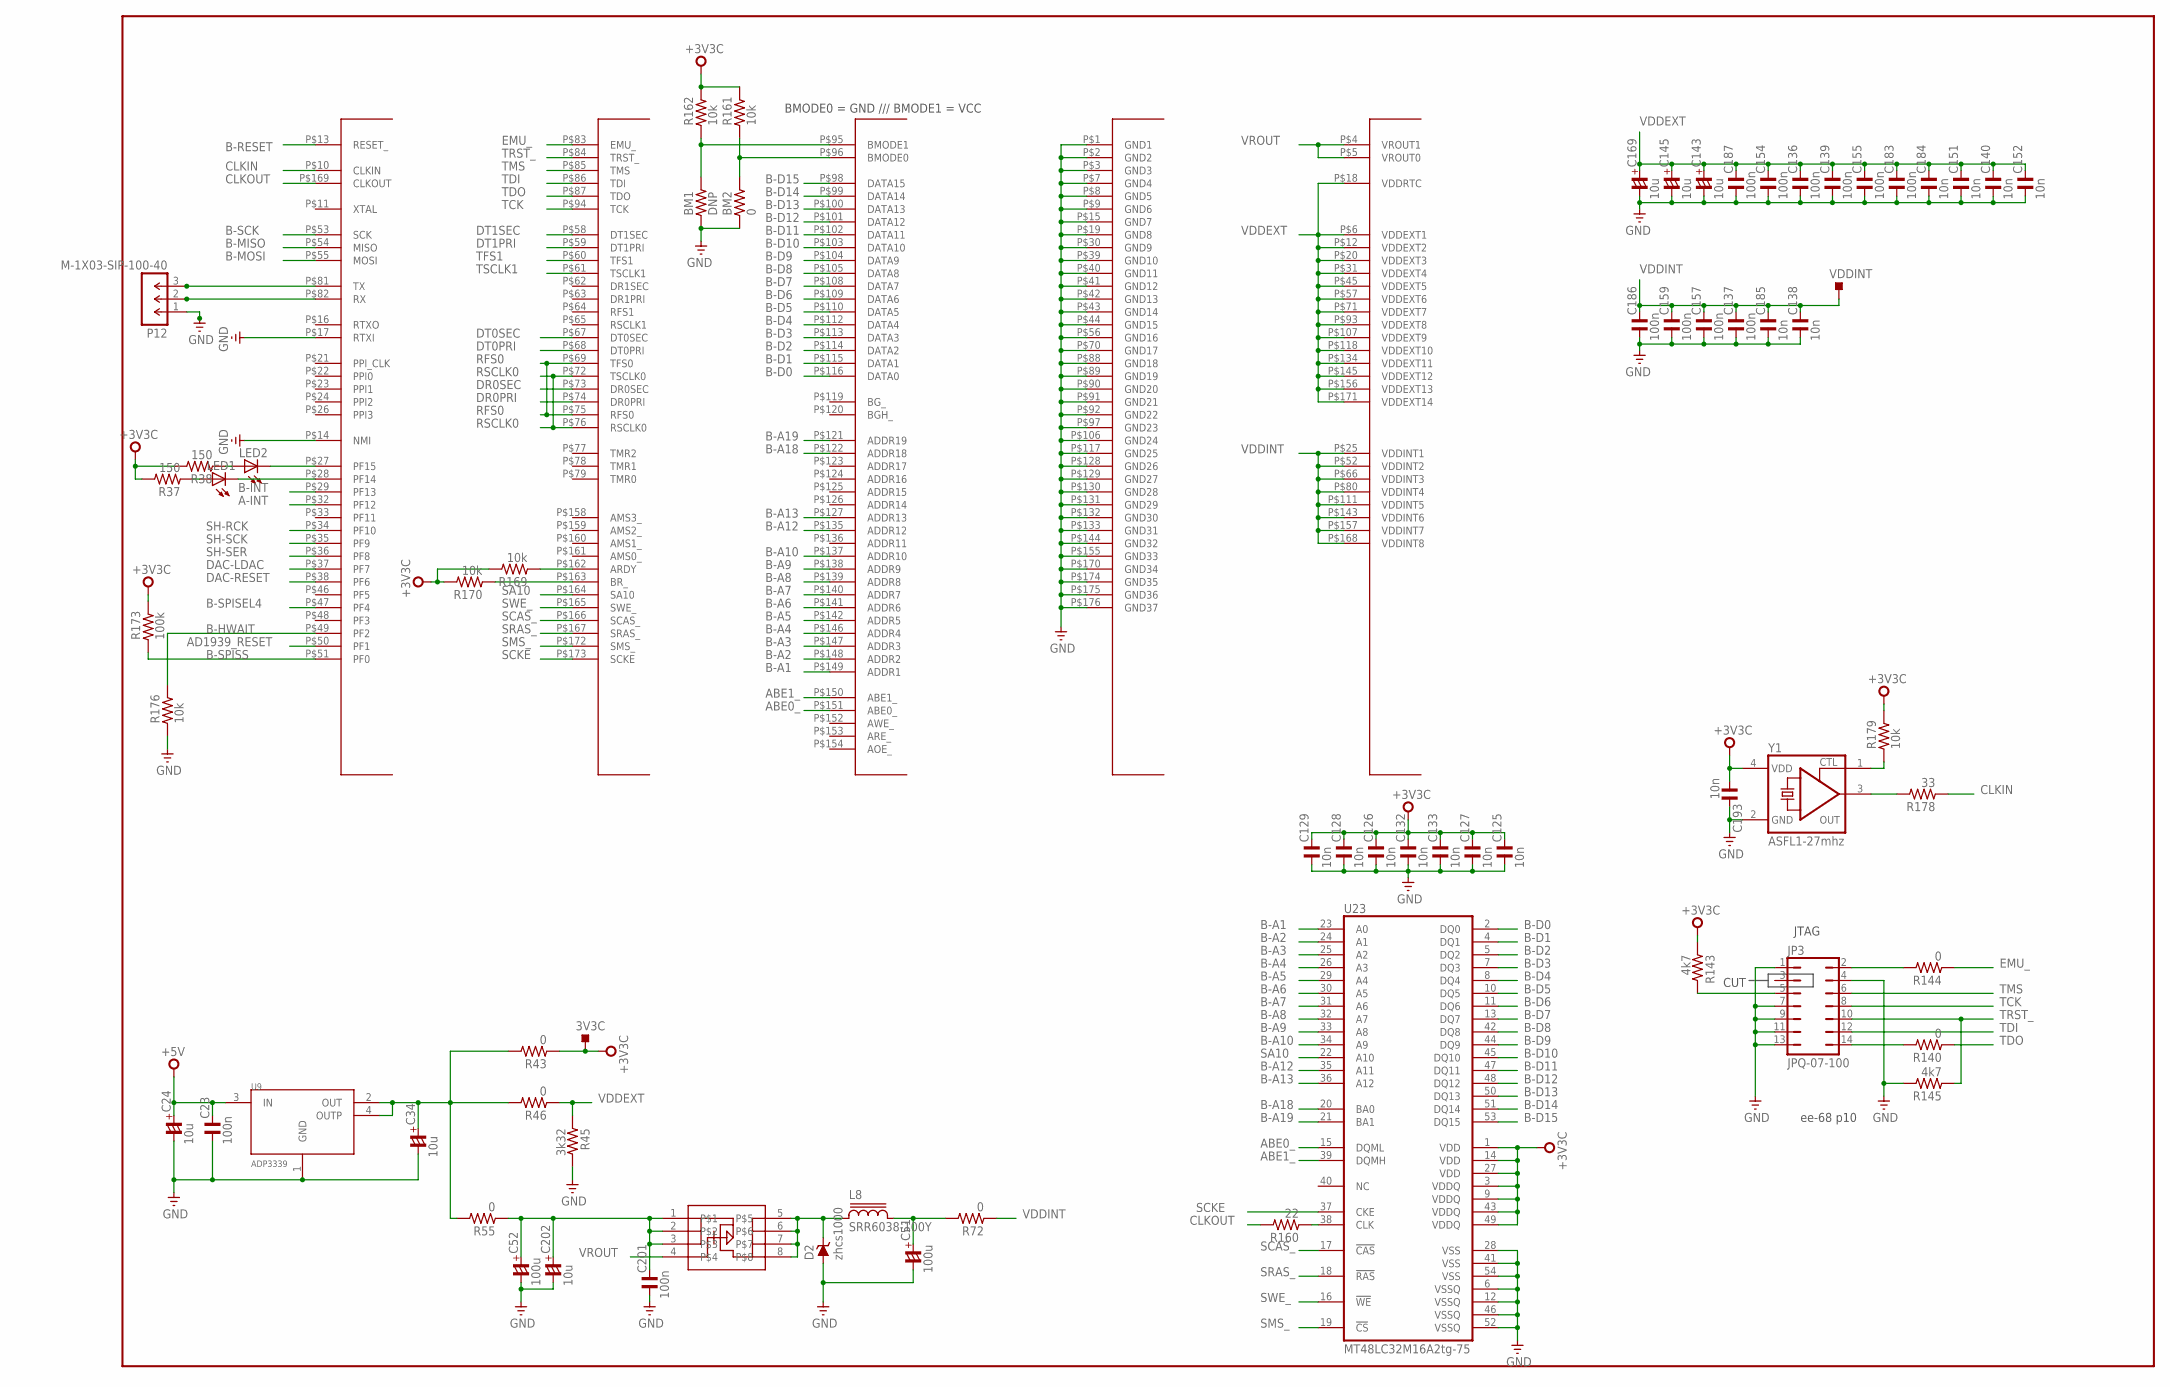
[picture p13: schematic aleph.sch, sheet 4]

Parts:
3V3C: TPS-SMD-15R; SMD-15R
BM1: DNP; R0603
BM2: 0; R0603
C23, C201: 100n; C1206
C24, C34, C143, C145, C169, C202: 10u; C1206/T
C51, C52: 100u; C1210/T
C125, C126, C127, C128, C129, C132, C133, C138, C140, C151, C152, C184, C185, C193: 10n; C0603
C136, C137, C139, C154, C155, C157, C159, C183, C186, C187: 100n; C0603
D2: zhcs1000; SOT23
DSP1: BF533; LQFP176
JP3: JPQ-07-100; JPQ-07
L8: SRR6038-100Y; SRR6038
LED1, LED2: LEDCHIPLED_0805; CHIPLED_0805
P12: M-1X03-SIP-100-40; SIP-100-03-40
R37, R38: 150; R0603
R43, R46, R55, R72, R140, R144: 0; R0603
R45: 3k32; R0603
R143, R145: 4k7; R0603
R160: 22; R0603
R161, R162, R169, R170, R176, R179: 10k; R0603
R173: 100k; R0603
R178: 33; R0603
U9: ADP3339; SOT223
U10: FDS9431A; SO08
U23: MT48LC32M16A2tg-75; TSOP54
VDDINT: TPS-SMD-10R; SMD-10R
Y1: ASFL1-27mhz; ASFL1

Connections:
+3V3C: 3V3C.TP, C125.2, C126.2, C127.2, C128.2, C129.2, C132.2, C133.2, C193.1, R37.2, R38.2, R43.1, R143.1, R161.2, R162.2, R169.2, R170.2, R173.2, R179.2, U23.1 (VDD), U23.3 (VDDQ), U23.9 (VDDQ), U23.14 (VDD), U23.27 (VDD), U23.43 (VDDQ), U23.49 (VDDQ), Y1.4 (VDD); also elsewhere on the board
+5V: C23.2, C24.+, U9.3 (IN); also elsewhere on the board
A-INT: DSP1.P$32 (PF12); also elsewhere on the board
ABE0_: DSP1.P$151 (ABE0_), U23.15 (DQML)
ABE1_: DSP1.P$150 (ABE1_), U23.39 (DQMH)
AD1939_RESET: DSP1.P$50 (PF1); also elsewhere on the board
B-A1: DSP1.P$149 (ADDR1), U23.23 (A0)
B-A2: DSP1.P$148 (ADDR2), U23.24 (A1)
B-A3: DSP1.P$147 (ADDR3), U23.25 (A2)
B-A4: DSP1.P$146 (ADDR4), U23.26 (A3)
B-A5: DSP1.P$142 (ADDR5), U23.29 (A4)
B-A6: DSP1.P$141 (ADDR6), U23.30 (A5)
B-A7: DSP1.P$140 (ADDR7), U23.31 (A6)
B-A8: DSP1.P$139 (ADDR8), U23.32 (A7)
B-A9: DSP1.P$138 (ADDR9), U23.33 (A8)
B-A10: DSP1.P$137 (ADDR10), U23.34 (A9)
B-A12: DSP1.P$135 (ADDR12), U23.35 (A11)
B-A13: DSP1.P$127 (ADDR13), U23.36 (A12)
B-A18: DSP1.P$122 (ADDR18), U23.20 (BA0)
B-A19: DSP1.P$121 (ADDR19), U23.21 (BA1)
B-D0: DSP1.P$116 (DATA0), U23.2 (DQ0)
B-D1: DSP1.P$115 (DATA1), U23.4 (DQ1)
B-D2: DSP1.P$114 (DATA2), U23.5 (DQ2)
B-D3: DSP1.P$113 (DATA3), U23.7 (DQ3)
B-D4: DSP1.P$112 (DATA4), U23.8 (DQ4)
B-D5: DSP1.P$110 (DATA5), U23.10 (DQ5)
B-D6: DSP1.P$109 (DATA6), U23.11 (DQ6)
B-D7: DSP1.P$108 (DATA7), U23.13 (DQ7)
B-D8: DSP1.P$105 (DATA8), U23.42 (DQ8)
B-D9: DSP1.P$104 (DATA9), U23.44 (DQ9)
B-D10: DSP1.P$103 (DATA10), U23.45 (DQ10)
B-D11: DSP1.P$102 (DATA11), U23.47 (DQ11)
B-D12: DSP1.P$101 (DATA12), U23.48 (DQ12)
B-D13: DSP1.P$100 (DATA13), U23.50 (DQ13)
B-D14: DSP1.P$99 (DATA14), U23.51 (DQ14)
B-D15: DSP1.P$98 (DATA15), U23.53 (DQ15)
B-HWAIT: DSP1.P$49 (PF2), R176.2; also elsewhere on the board
B-INT: DSP1.P$29 (PF13); also elsewhere on the board
B-MISO: DSP1.P$54 (MISO); also elsewhere on the board
B-MOSI: DSP1.P$55 (MOSI); also elsewhere on the board
B-RESET: DSP1.P$13 (RESET_); also elsewhere on the board
B-SCK: DSP1.P$53 (SCK); also elsewhere on the board
B-SPISEL4: DSP1.P$47 (PF4)
B-SPISS: DSP1.P$51 (PF0), R173.1; also elsewhere on the board
BMODE0: BM2.2, DSP1.P$96 (BMODE0), R161.1
BMODE1: BM1.2, DSP1.P$95 (BMODE1), R162.1
CLKIN: DSP1.P$10 (CLKIN), R178.1
CLKOUT: DSP1.P$169 (CLKOUT), R160.2
DAC-LDAC: DSP1.P$37 (PF7); also elsewhere on the board
DAC-RESET: DSP1.P$38 (PF6); also elsewhere on the board
DR0PRI: DSP1.P$74 (DR0PRI); also elsewhere on the board
DR0SEC: DSP1.P$73 (DR0SEC); also elsewhere on the board
DT0PRI: DSP1.P$68 (DT0PRI); also elsewhere on the board
DT0SEC: DSP1.P$67 (DT0SEC); also elsewhere on the board
DT1PRI: DSP1.P$59 (DT1PRI)
DT1SEC: DSP1.P$58 (DT1SEC); also elsewhere on the board
EMU_: DSP1.P$83 (EMU_), R144.1
GND: BM1.1, BM2.1, C23.1, C24.-, C34.-, C51.-, C52.-, C125.1, C126.1, C127.1, C128.1, C129.1, C132.1, C133.1, C136.1, C137.1, C138.1, C139.1, C140.1, C143.-, C145.-, C151.1, C152.1, C154.1, C155.1, C157.1, C159.1, C169.-, C183.1, C184.1, C185.1, C186.1, C187.1, C193.2, C201.1, C202.-, D2.1 (A), DSP1.P$1 (GND1), DSP1.P$2 (GND2), DSP1.P$3 (GND3), DSP1.P$7 (GND4), DSP1.P$8 (GND5), DSP1.P$9 (GND6), DSP1.P$14 (NMI), DSP1.P$15 (GND7), DSP1.P$17 (RTXI), DSP1.P$19 (GND8), DSP1.P$30 (GND9), DSP1.P$39 (GND10), DSP1.P$40 (GND11), DSP1.P$41 (GND12), DSP1.P$42 (GND13), DSP1.P$43 (GND14), DSP1.P$44 (GND15), DSP1.P$56 (GND16), DSP1.P$70 (GND17), DSP1.P$88 (GND18), DSP1.P$89 (GND19), DSP1.P$90 (GND20), DSP1.P$91 (GND21), DSP1.P$92 (GND22), DSP1.P$97 (GND23), DSP1.P$106 (GND24), DSP1.P$117 (GND25), DSP1.P$128 (GND26), DSP1.P$129 (GND27), DSP1.P$130 (GND28), DSP1.P$131 (GND29), DSP1.P$132 (GND30), DSP1.P$133 (GND31), DSP1.P$144 (GND32), DSP1.P$155 (GND33), DSP1.P$170 (GND34), DSP1.P$174 (GND35), DSP1.P$175 (GND36), DSP1.P$176 (GND37), JP3.1, JP3.4, JP3.7, JP3.9, JP3.11, JP3.13, P12.1, R45.2, R145.2, R176.1, U9.1 (GND), U23.6 (VSSQ), U23.12 (VSSQ), U23.28 (VSS), U23.41 (VSS), U23.46 (VSSQ), U23.52 (VSSQ), U23.54 (VSS), Y1.2 (GND); also elsewhere on the board
unnamed: C34.+, R43.2, R46.2, R55.2, U9.2 (OUT), U9.4 (OUTP)
unnamed: C52.+, C201.2, C202.+, R55.1, U10.1, U10.2, U10.3
unnamed: D2.3 (C), L8.1, U10.5, U10.6, U10.7, U10.8
unnamed: C51.+, L8.2, R72.2
unnamed: R160.1, U23.38 (CLK)
unnamed: R179.1, Y1.1 (CTL)
unnamed: JP3.2, R144.2
unnamed: JP3.5, R143.2
unnamed: DSP1.P$163 (BR_), R170.1
unnamed: JP3.14, R140.2
unnamed: DSP1.P$162 (ARDY), R169.1
unnamed: R178.2, Y1.3 (OUT)
unnamed: DSP1.P$27 (PF15), LED2.C
unnamed: DSP1.P$28 (PF14), LED1.C
unnamed: LED2.A, R38.1
unnamed: LED1.A, R37.1
unnamed: DSP1.P$81 (TX), P12.3
unnamed: DSP1.P$82 (RX), P12.2
RFS0: DSP1.P$69 (TFS0), DSP1.P$75 (RFS0); also elsewhere on the board
RSCLK0: DSP1.P$72 (TSCLK0), DSP1.P$76 (RSCLK0); also elsewhere on the board
SA10: DSP1.P$164 (SA10), U23.22 (A10)
SCAS_: DSP1.P$166 (SCAS_), U23.17 (!CAS!)
SCKE: DSP1.P$173 (SCKE), U23.37 (CKE)
SH-RCK: DSP1.P$34 (PF10)
SH-SCK: DSP1.P$35 (PF9)
SH-SER: DSP1.P$36 (PF8)
SMS_: DSP1.P$172 (SMS_), U23.19 (!CS!)
SRAS_: DSP1.P$167 (SRAS_), U23.18 (!RAS!)
SWE_: DSP1.P$165 (SWE_), U23.16 (!WE!)
TCK: DSP1.P$94 (TCK), JP3.8
TDI: DSP1.P$86 (TDI), JP3.12
TDO: DSP1.P$87 (TDO), R140.1
TFS1: DSP1.P$60 (TFS1); also elsewhere on the board
TMS: DSP1.P$85 (TMS), JP3.6
TRST_: DSP1.P$84 (TRST_), JP3.10, R145.1
TSCLK1: DSP1.P$61 (TSCLK1); also elsewhere on the board
VDDEXT: C136.2, C139.2, C140.2, C143.+, C145.+, C151.2, C152.2, C154.2, C155.2, C169.+, C183.2, C184.2, C187.2, DSP1.P$6 (VDDEXT1), DSP1.P$12 (VDDEXT2), DSP1.P$18 (VDDRTC), DSP1.P$20 (VDDEXT3), DSP1.P$31 (VDDEXT4), DSP1.P$45 (VDDEXT5), DSP1.P$57 (VDDEXT6), DSP1.P$71 (VDDEXT7), DSP1.P$93 (VDDEXT8), DSP1.P$107 (VDDEXT9), DSP1.P$118 (VDDEXT10), DSP1.P$134 (VDDEXT11), DSP1.P$145 (VDDEXT12), DSP1.P$156 (VDDEXT13), DSP1.P$171 (VDDEXT14), R45.1, R46.1
VDDINT: C137.2, C138.2, C157.2, C159.2, C185.2, C186.2, DSP1.P$25 (VDDINT1), DSP1.P$52 (VDDINT2), DSP1.P$66 (VDDINT3), DSP1.P$80 (VDDINT4), DSP1.P$111 (VDDINT5), DSP1.P$143 (VDDINT6), DSP1.P$157 (VDDINT7), DSP1.P$168 (VDDINT8), R72.1, VDDINT.TP
VROUT: DSP1.P$4 (VROUT1), DSP1.P$5 (VROUT0), U10.4

Notes on the sheet:
ee-68 p10
CUT
JTAG
BMODE0 = GND /// BMODE1 = VCC

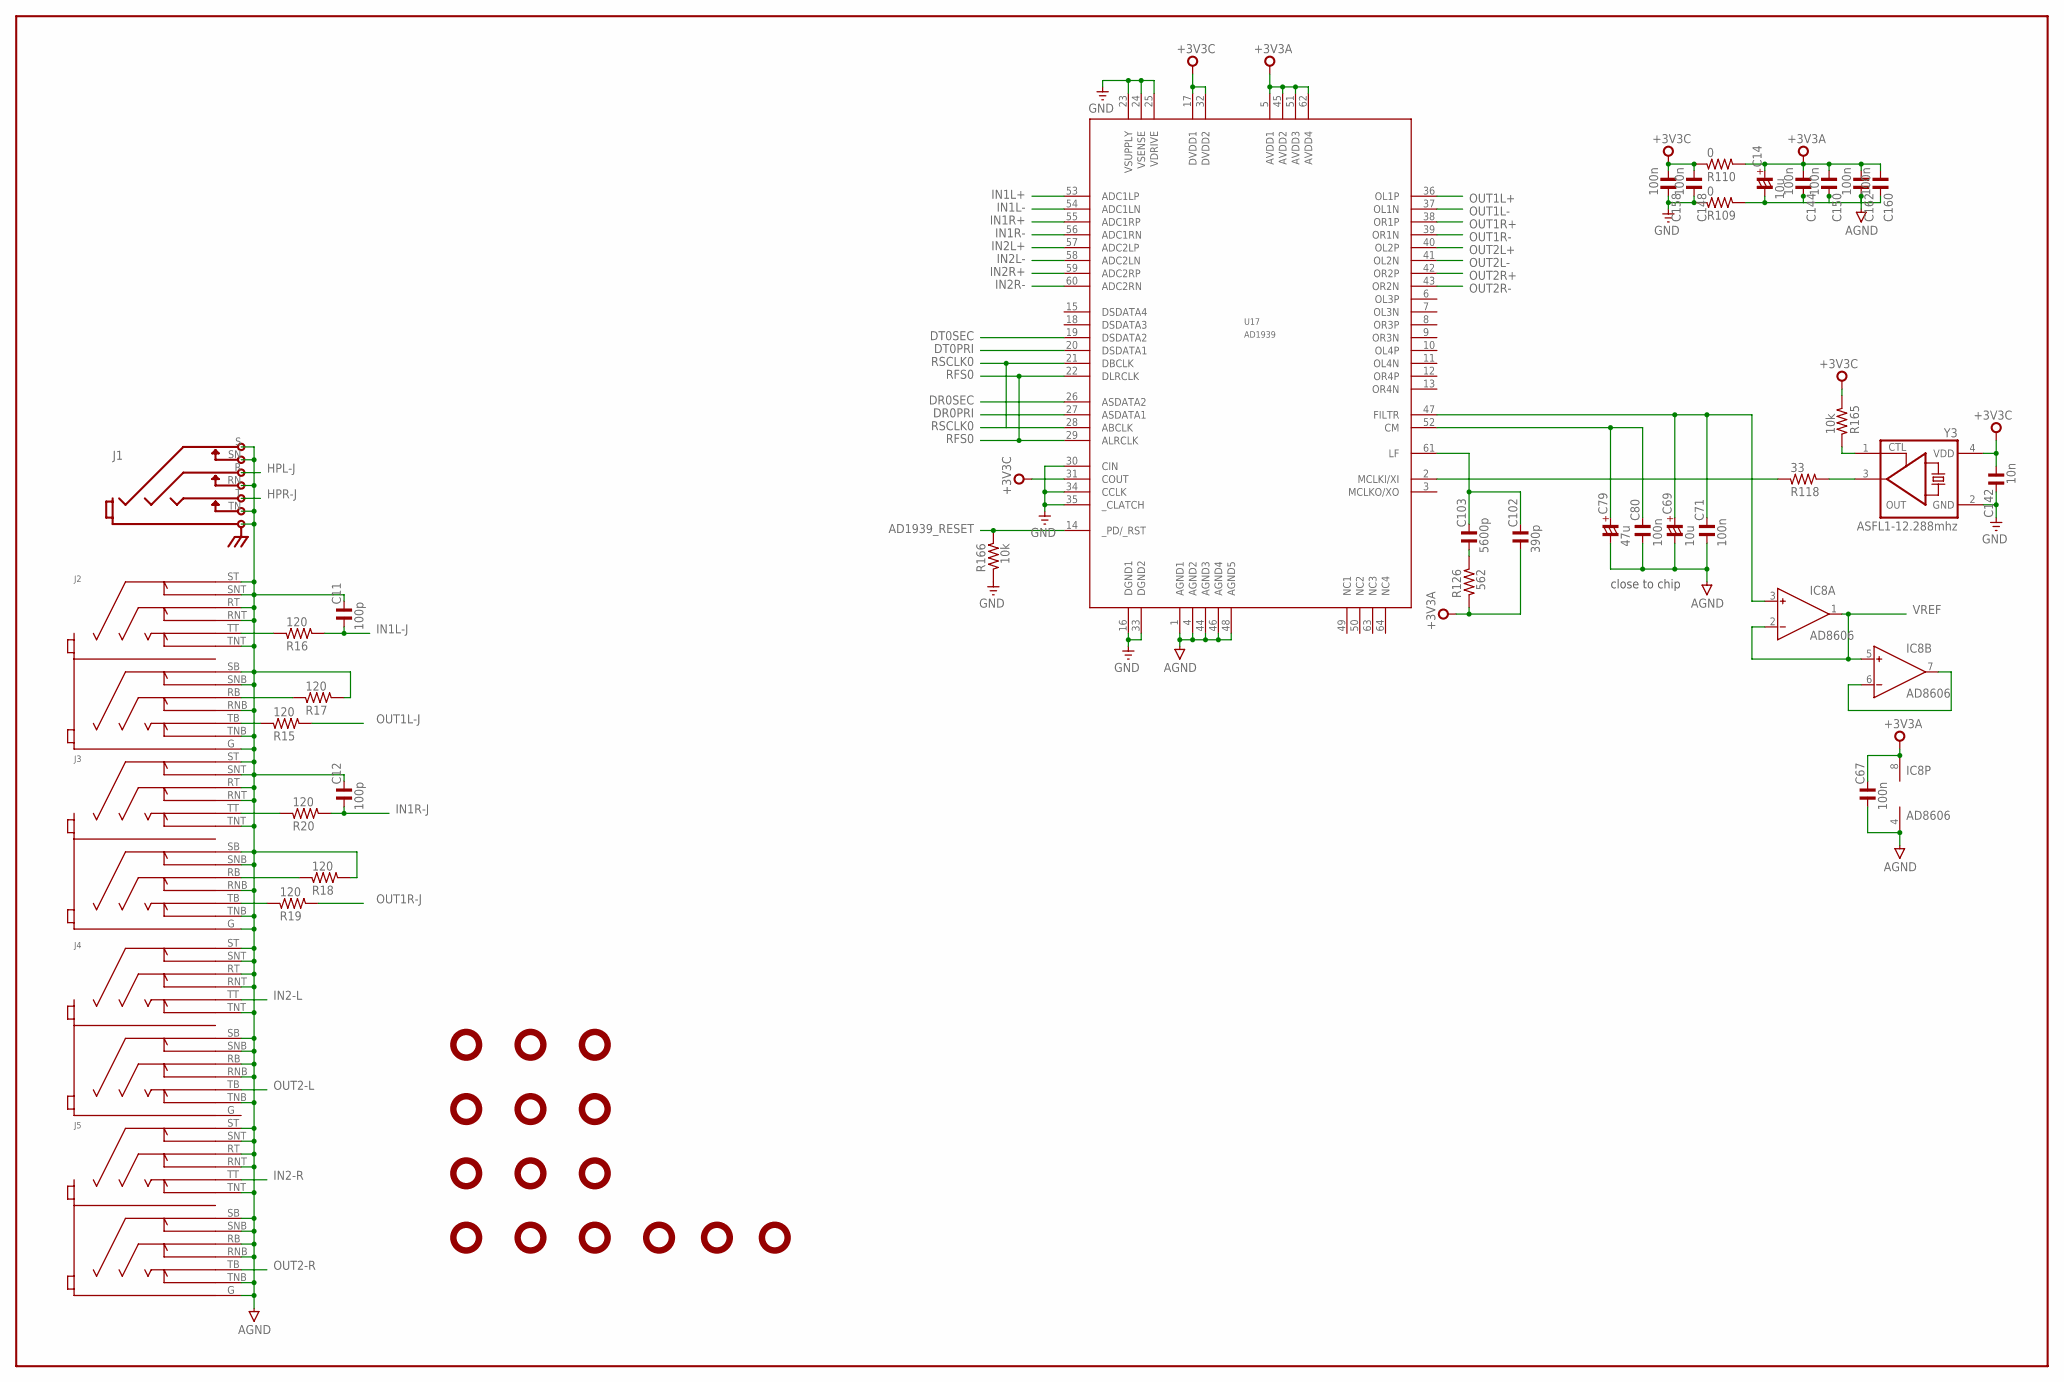
[picture p14: schematic aleph.sch, sheet 5]

Parts:
C11, C12: 100p; C0603
C14, C69: 10u; C1206/T
C67, C71, C80, C144, C148, C150, C158, C160, C162: 100n; C0603
C79: 47u; C1206/T
C102: 390p; C0603
C103: 5600p; C0603
C142: 10n; C0603
H1, H2, H3, H4, H5, H6, H7, H8, H9, H10, H11, H12, H13, H14, H15: MOUNT440; 120-PAD-NS
IC8: AD8606; SO8
J1: STEREOSW3GND; NEUTRIK-NRJ6HF-1
J2, J3, J4, J5: NSJ12HF
R15, R16, R17, R18, R19, R20: 120; R0603
R109, R110: 0; R0603
R118: 33; R0603
R126: 562; R0603
R165, R166: 10k; R0603
U17: AD1939; SQFP-S-10X10-64
Y3: ASFL1-12.288mhz; ASFL1

Connections:
+3V3A: C14.+, C67.2, C102.1, C144.1, C150.1, C160.1, C162.1, IC8.8 (V+), R110.2, R126.2, U17.5 (AVDD1), U17.45 (AVDD2), U17.51 (AVDD3), U17.62 (AVDD4); also elsewhere on the board
+3V3C: C142.1, C148.1, C158.1, R110.1, R165.2, U17.17 (DVDD1), U17.31 (COUT), U17.32 (DVDD2), Y3.4 (VDD); also elsewhere on the board
AD1939_RESET: R166.1, U17.14 (_PD/_RST); also elsewhere on the board
AGND: C11.2, C12.2, C14.-, C67.1, C69.-, C71.1, C79.-, C80.1, C144.2, C150.2, C160.2, C162.2, IC8.4 (V-), J1.RN, J1.S, J1.SN, J1.TN, J2.G, J2.RNB, J2.RNT, J2.RT, J2.SB, J2.SNB, J2.SNT, J2.ST, J2.TNB, J2.TNT, J3.G, J3.RNB, J3.RNT, J3.RT, J3.SB, J3.SNB, J3.SNT, J3.ST, J3.TNB, J3.TNT, J4.RB, J4.RNB, J4.RNT, J4.RT, J4.SB, J4.SNB, J4.SNT, J4.ST, J4.TNB, J4.TNT, J5.G, J5.RB, J5.RNB, J5.RNT, J5.RT, J5.SB, J5.SNB, J5.SNT, J5.ST, J5.TNB, J5.TNT, R17.2, R18.2, R109.2, U17.1 (AGND1), U17.4 (AGND2), U17.44 (AGND3), U17.46 (AGND4), U17.48 (AGND5); also elsewhere on the board
DR0PRI: U17.27 (ASDATA1); also elsewhere on the board
DR0SEC: U17.26 (ASDATA2); also elsewhere on the board
DT0PRI: U17.20 (DSDATA1); also elsewhere on the board
DT0SEC: U17.19 (DSDATA2); also elsewhere on the board
GND: C142.2, C148.2, C158.2, R109.1, R166.2, U17.16 (DGND1), U17.23 (VSUPPLY), U17.24 (VSENSE), U17.25 (VDRIVE), U17.30 (CIN), U17.33 (DGND2), U17.34 (CCLK), U17.35 (_CLATCH), Y3.2 (GND); also elsewhere on the board
HPL-J: J1.R; also elsewhere on the board
HPR-J: J1.T; also elsewhere on the board
IN1L+: U17.53 (ADC1LP); also elsewhere on the board
IN1L-: U17.54 (ADC1LN); also elsewhere on the board
IN1L-J: C11.1, R16.2; also elsewhere on the board
IN1R+: U17.55 (ADC1RP); also elsewhere on the board
IN1R-: U17.56 (ADC1RN); also elsewhere on the board
IN1R-J: C12.1, R20.2; also elsewhere on the board
IN2-L: J4.TT; also elsewhere on the board
IN2-R: J5.TT; also elsewhere on the board
IN2L+: U17.57 (ADC2LP); also elsewhere on the board
IN2L-: U17.58 (ADC2LN); also elsewhere on the board
IN2R+: U17.59 (ADC2RP); also elsewhere on the board
IN2R-: U17.60 (ADC2RN); also elsewhere on the board
unnamed: R165.1, Y3.1 (CTL)
unnamed: R118.2, Y3.3 (OUT)
unnamed: R118.1, U17.2 (MCLKI/XI)
unnamed: C69.+, C71.2, IC8.3 (IN+), U17.47 (FILTR)
unnamed: C79.+, C80.2, U17.52 (CM)
unnamed: C102.2, C103.2, U17.61 (LF)
unnamed: C103.1, R126.1
unnamed: J3.TB, R19.1
unnamed: J3.RB, R18.1
unnamed: IC8.6 (IN-), IC8.7 (OUT)
unnamed: J2.TB, R15.1
unnamed: J2.RB, R17.1
unnamed: J3.TT, R20.1
unnamed: J2.TT, R16.1
OUT1L+: U17.36 (OL1P); also elsewhere on the board
OUT1L-: U17.37 (OL1N); also elsewhere on the board
OUT1L-J: R15.2; also elsewhere on the board
OUT1R+: U17.38 (OR1P); also elsewhere on the board
OUT1R-: U17.39 (OR1N); also elsewhere on the board
OUT1R-J: R19.2; also elsewhere on the board
OUT2-L: J4.TB; also elsewhere on the board
OUT2-R: J5.TB; also elsewhere on the board
OUT2L+: U17.40 (OL2P); also elsewhere on the board
OUT2L-: U17.41 (OL2N); also elsewhere on the board
OUT2R+: U17.42 (OR2P); also elsewhere on the board
OUT2R-: U17.43 (OR2N); also elsewhere on the board
RFS0: U17.22 (DLRCLK), U17.29 (ALRCLK); also elsewhere on the board
RSCLK0: U17.21 (DBCLK), U17.28 (ABCLK); also elsewhere on the board
VREF: IC8.1 (OUT), IC8.2 (IN-), IC8.5 (IN+); also elsewhere on the board

Notes on the sheet:
close to chip

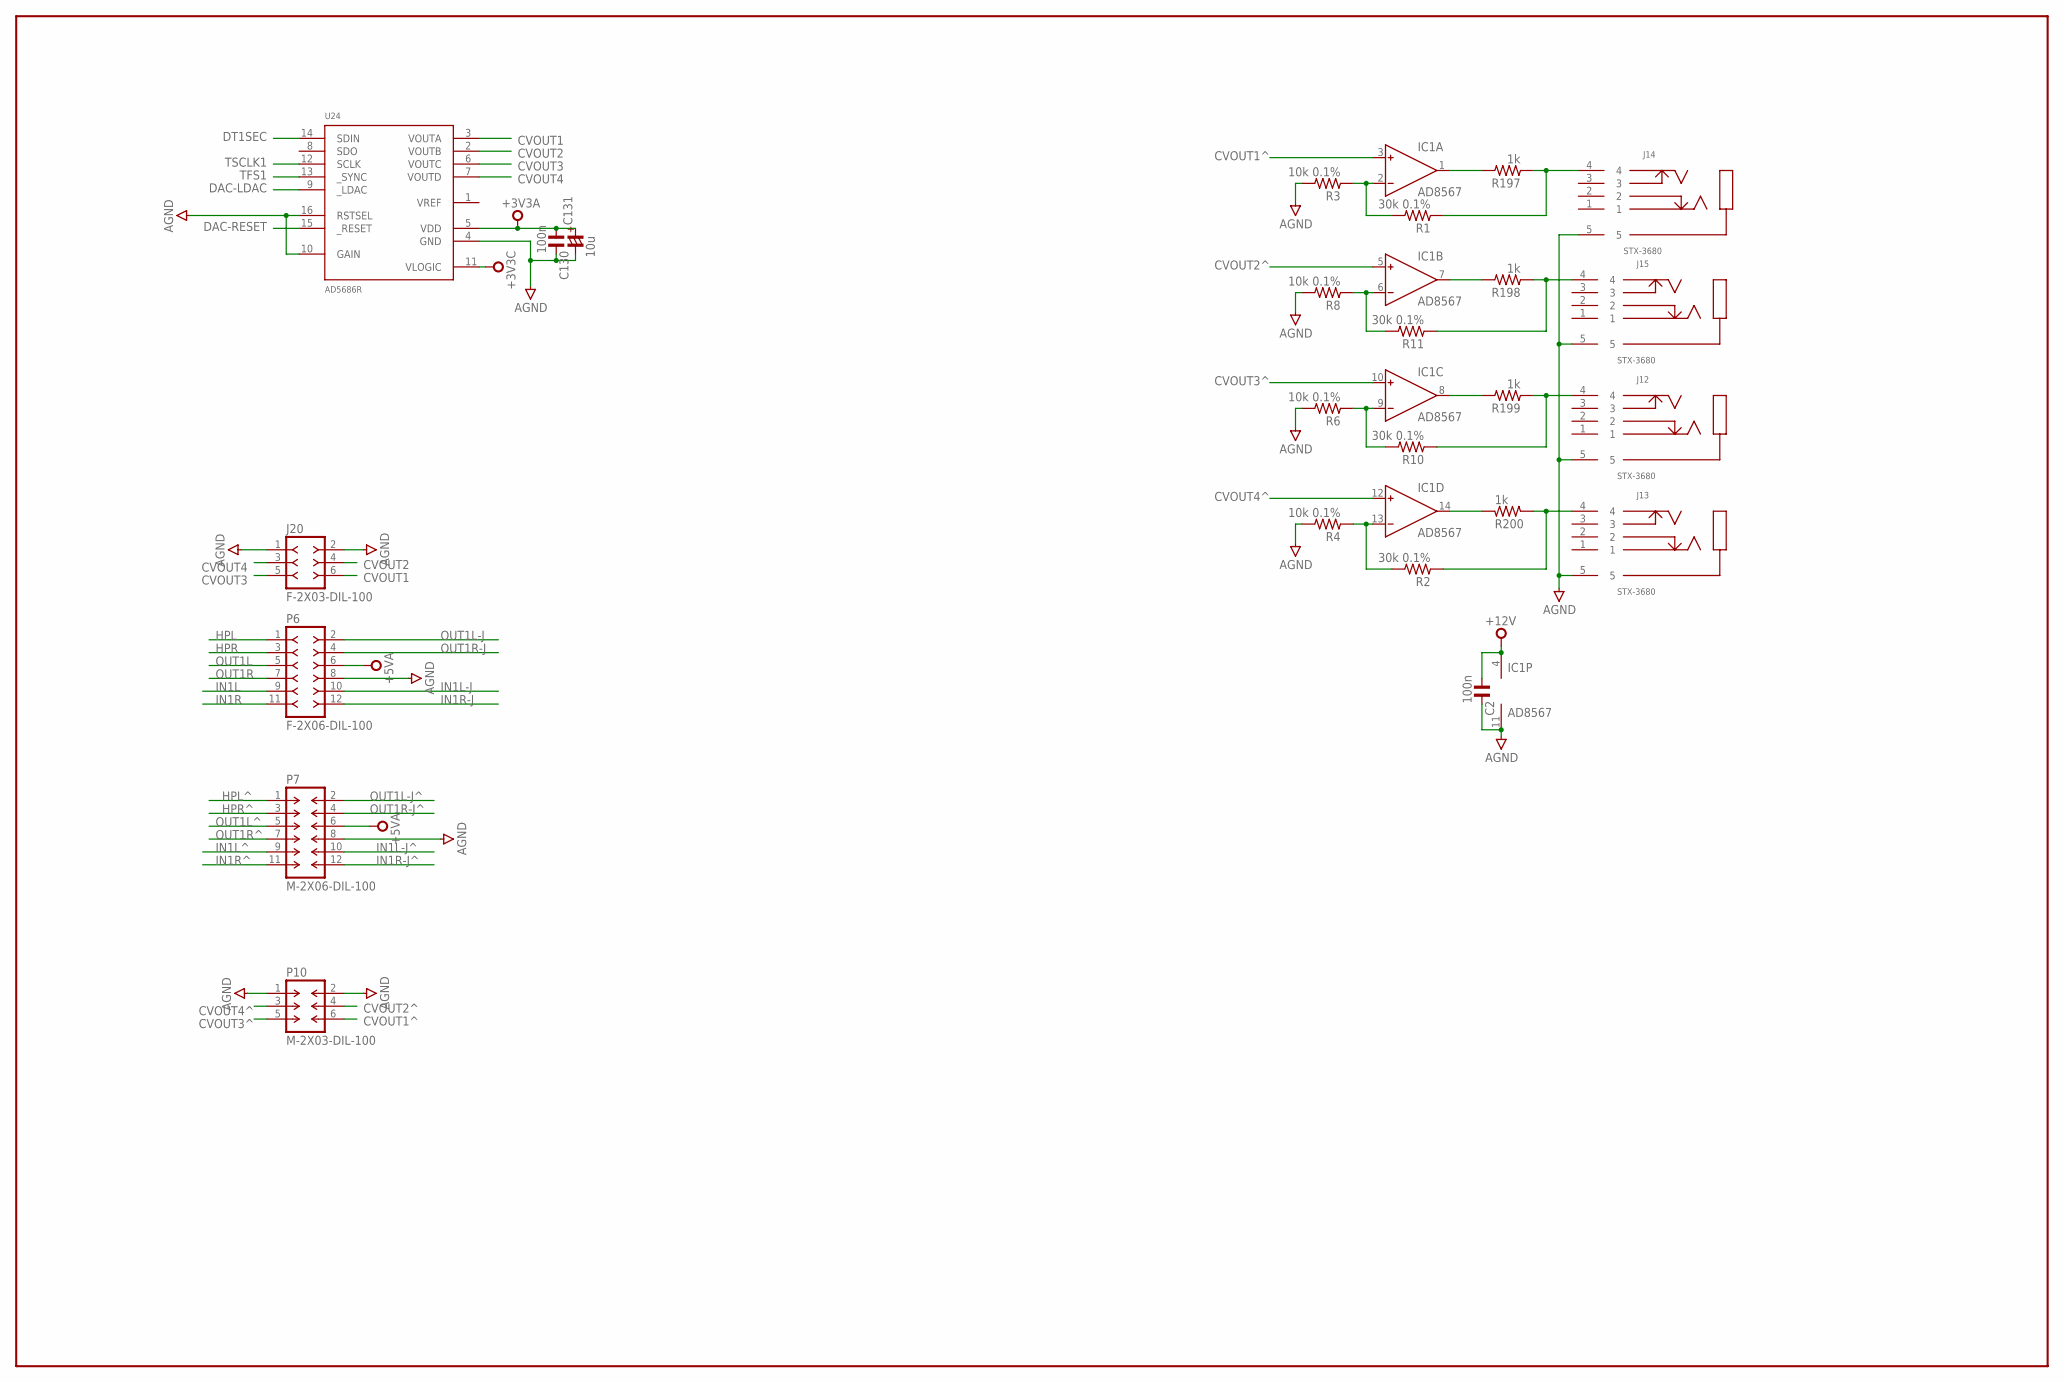
[picture p15: schematic aleph.sch, sheet 6]

Parts:
C2, C130: 100n; C0603
C131: 10u; C1206/T
IC1: AD8567; TSSOP14
J12, J13, J14, J15: STX-3680
J20: F-2X03-DIL-100; DIL-100-2X03
P6: F-2X06-DIL-100; DIL-100-2X06
P7: M-2X06-DIL-100; DIL-100-2X06
P10: M-2X03-DIL-100; DIL-100-2X03
R1, R2, R10, R11: 30k 0.1%; R0603
R3, R4, R6, R8: 10k 0.1%; R0603
R197, R198, R199, R200: 1k; R0603
U24: AD5686R; TSSOP16

Connections:
+3V3A: C130.1, C131.+, U24.5 (VDD); also elsewhere on the board
+3V3C: U24.11 (VLOGIC); also elsewhere on the board
+5VA: P6.6, P7.6; also elsewhere on the board
+12V: C2.1, IC1.4 (V+); also elsewhere on the board
AGND: C2.2, C130.2, C131.-, IC1.11 (V-), J12.5, J13.5, J14.5, J15.5, J20.1, J20.2, P6.8, P7.8, P10.1, P10.2, R3.2, R4.2, R6.2, R8.2, U24.4 (GND), U24.10 (GAIN), U24.16 (RSTSEL); also elsewhere on the board
CVOUT1: J20.6, U24.3 (VOUTA)
CVOUT1^: IC1.3 (IN+), P10.6
CVOUT2: J20.4, U24.2 (VOUTB)
CVOUT2^: IC1.5 (IN+), P10.4
CVOUT3: J20.5, U24.6 (VOUTC)
CVOUT3^: IC1.10 (IN+), P10.5
CVOUT4: J20.3, U24.7 (VOUTD)
CVOUT4^: IC1.12 (IN+), P10.3
DAC-LDAC: U24.9 (_LDAC); also elsewhere on the board
DAC-RESET: U24.15 (_RESET); also elsewhere on the board
DT1SEC: U24.14 (SDIN); also elsewhere on the board
HPL: P6.1; also elsewhere on the board
HPL^: P7.1; also elsewhere on the board
HPR: P6.3; also elsewhere on the board
HPR^: P7.3; also elsewhere on the board
IN1L: P6.9; also elsewhere on the board
IN1L-J: P6.10; also elsewhere on the board
IN1L-J^: P7.10; also elsewhere on the board
IN1L^: P7.9; also elsewhere on the board
IN1R: P6.11; also elsewhere on the board
IN1R-J: P6.12; also elsewhere on the board
IN1R-J^: P7.12; also elsewhere on the board
IN1R^: P7.11; also elsewhere on the board
unnamed: IC1.2 (IN-), R1.2, R3.1
unnamed: IC1.14 (OUT), R200.1
unnamed: J14.4, R1.1, R197.1
unnamed: IC1.8 (OUT), R199.2
unnamed: IC1.7 (OUT), R198.2
unnamed: IC1.6 (IN-), R8.1, R11.2
unnamed: IC1.9 (IN-), R6.1, R10.2
unnamed: IC1.13 (IN-), R2.2, R4.1
unnamed: J12.4, R10.1, R199.1
unnamed: J13.4, R2.1, R200.2
unnamed: J15.4, R11.1, R198.1
unnamed: IC1.1 (OUT), R197.2
OUT1L: P6.5; also elsewhere on the board
OUT1L-J: P6.2; also elsewhere on the board
OUT1L-J^: P7.2; also elsewhere on the board
OUT1L^: P7.5; also elsewhere on the board
OUT1R: P6.7; also elsewhere on the board
OUT1R-J: P6.4; also elsewhere on the board
OUT1R-J^: P7.4; also elsewhere on the board
OUT1R^: P7.7; also elsewhere on the board
TFS1: U24.13 (_SYNC); also elsewhere on the board
TSCLK1: U24.12 (SCLK); also elsewhere on the board
