monome/aleph-hardware/eagle/aleph.brd

## EAGLE design eagle/aleph.brd (continued)

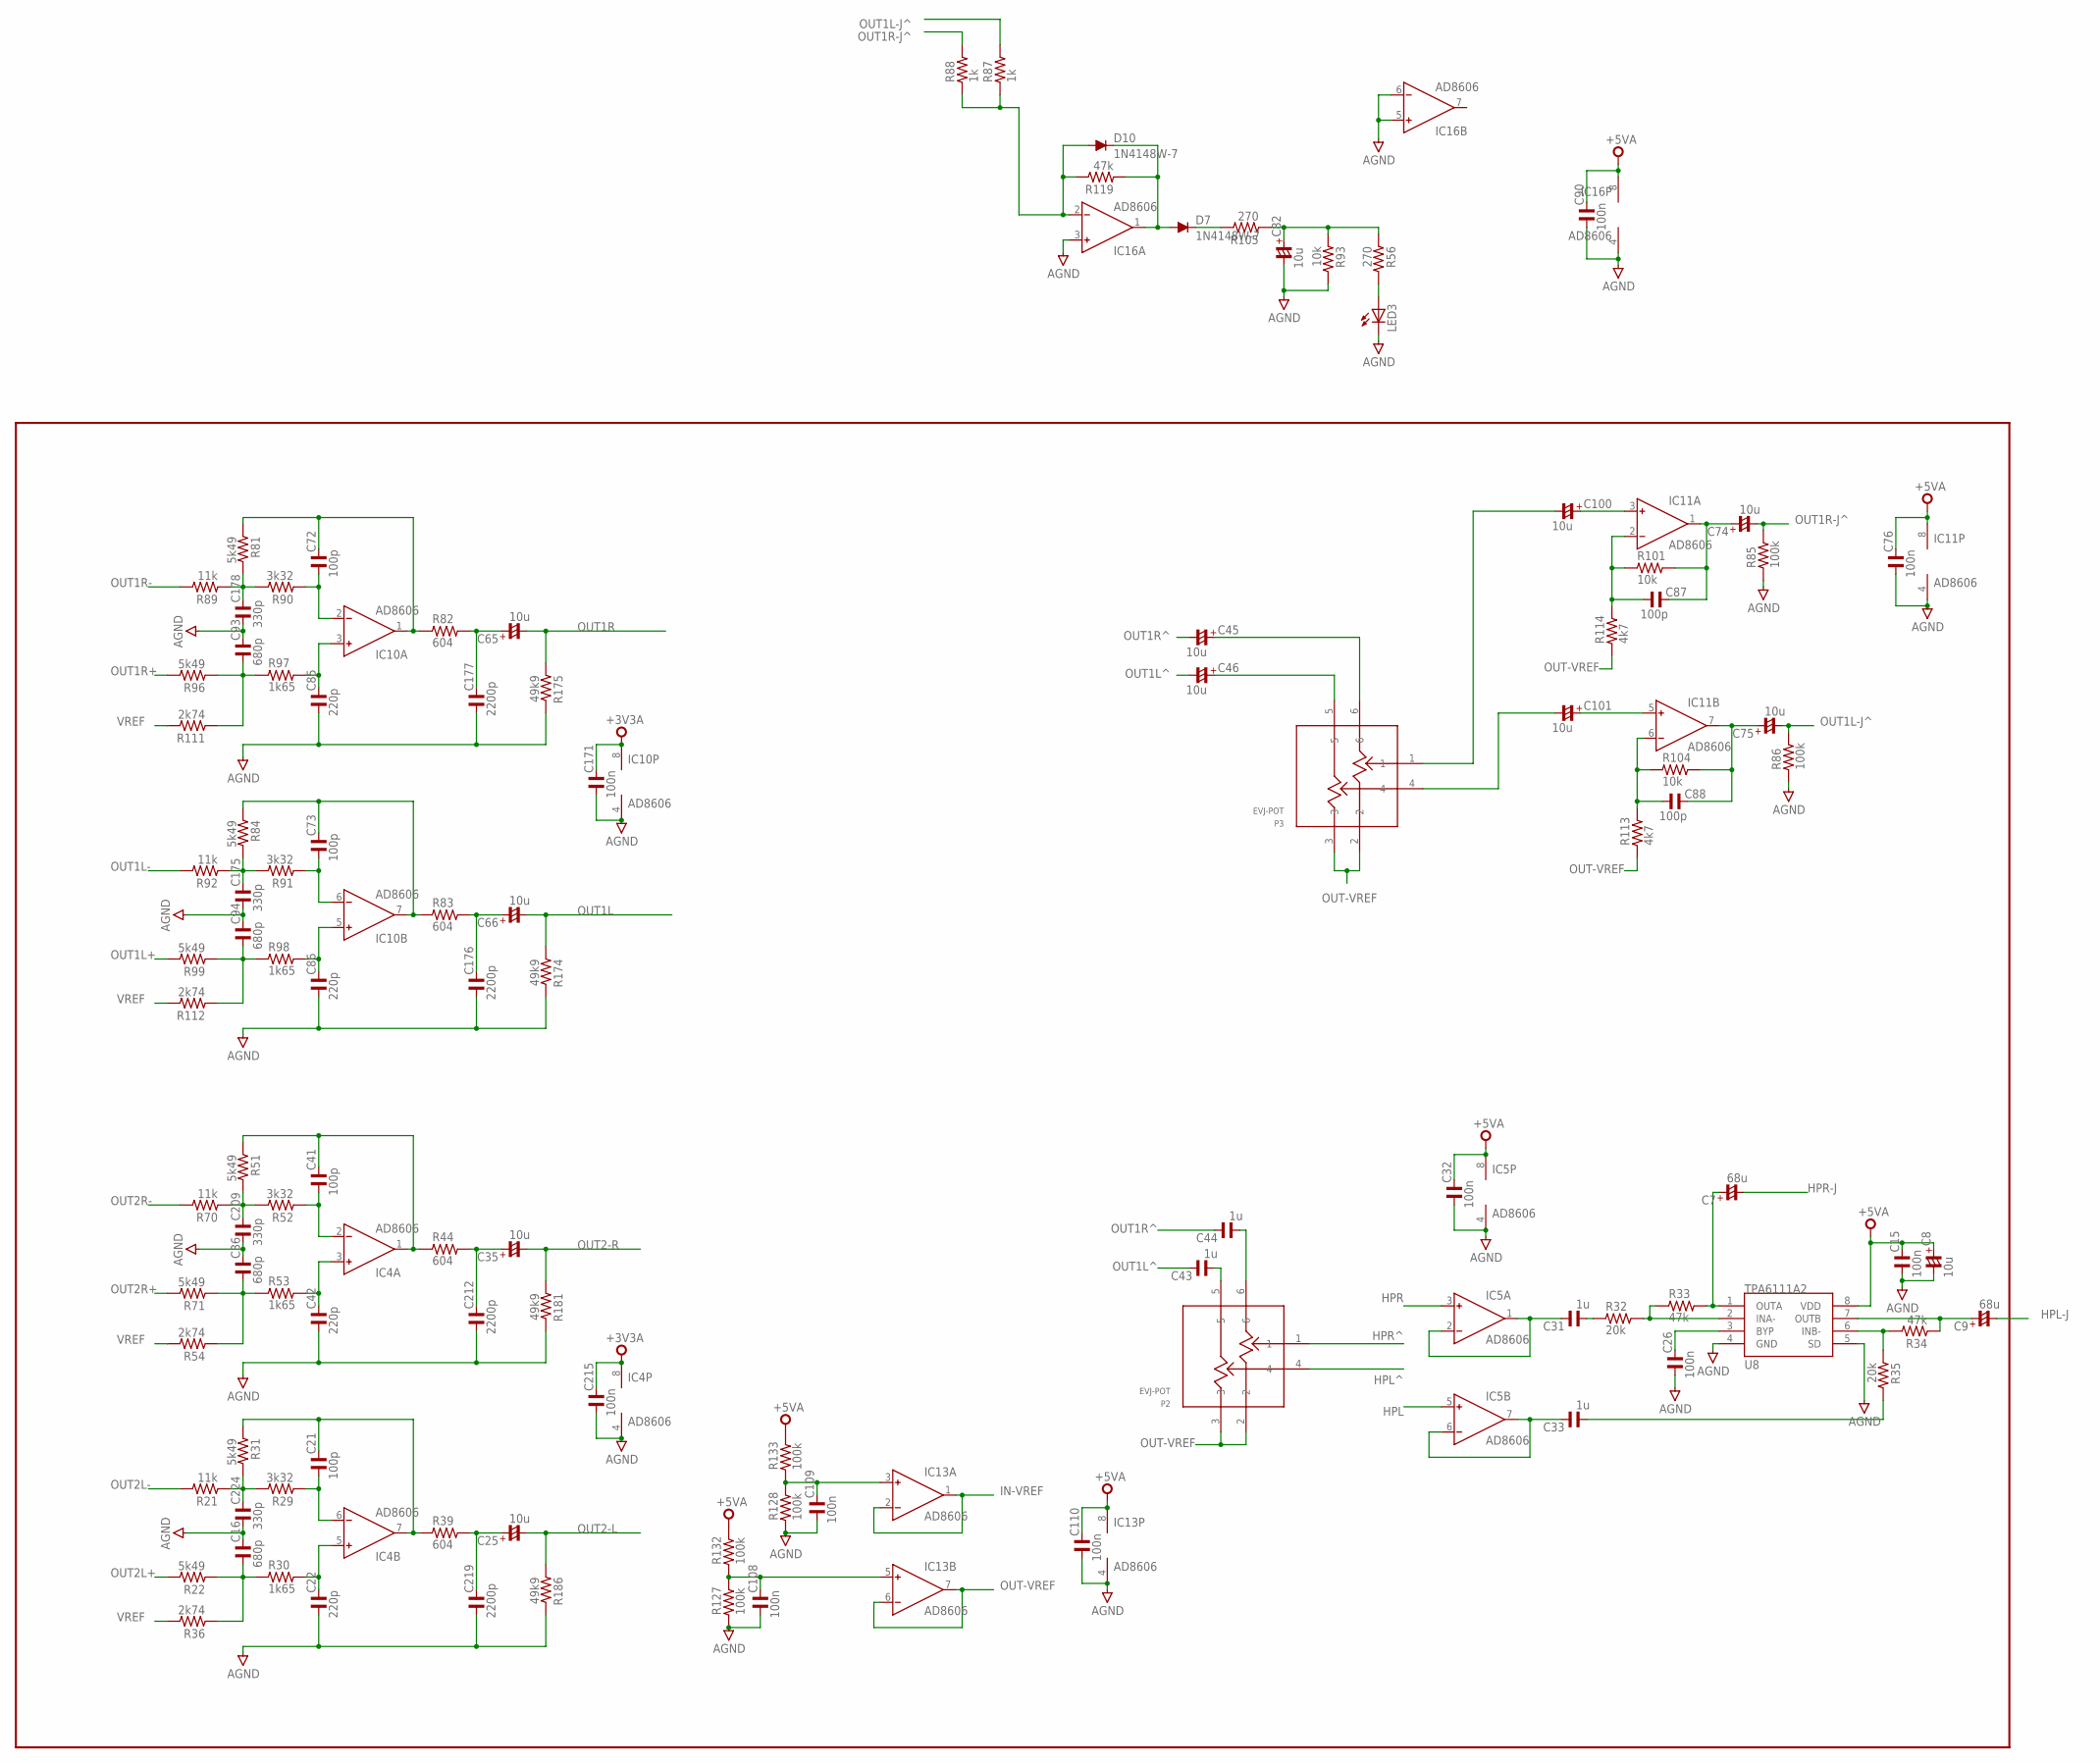
[picture p16: schematic aleph.sch, sheet 7]

Parts:
C7, C9: 68u; C1206/T
C8, C25, C35, C45, C46, C65, C66, C74, C75, C82, C100, C101: 10u; C1206/T
C15, C26, C32, C76, C90, C108, C109, C110, C171, C215: 100n; C0603
C16, C36, C93, C94: 680p; C0603
C21, C41, C72, C73, C87, C88: 100p; C0603
C22, C42, C85, C86: 220p; C0603
C31, C33, C43, C44: 1u; C0603
C175, C178, C209, C224: 330p; C0603
C176, C177, C212, C219: 2200p; C0603
D7, D10: 1N4148W-7; SOD123
IC4, IC5, IC10, IC11, IC13, IC16: AD8606; SO8
LED3: LEDCHIPLED_0805; CHIPLED_0805
P2, P3: EVJ-POT
R21, R70, R89, R92: 11k; R0603
R22, R31, R51, R71, R81, R84, R96, R99: 5k49; R0603
R29, R52, R90, R91: 3k32; R0603
R30, R53, R97, R98: 1k65; R0603
R32, R35: 20k; R0603
R33, R34, R119: 47k; R0603
R36, R54, R111, R112: 2k74; R0603
R39, R44, R82, R83: 604; R0603
R56, R105: 270; R0603
R85, R86, R127, R128, R132, R133: 100k; R0603
R87, R88: 1k; R0603
R93, R101, R104: 10k; R0603
R113, R114: 4k7; R0603
R174, R175, R181, R186: 49k9; R0603
U8: TPA6111A2; SO08

Connections:
+3V3A: C171.2, C215.2, IC4.8 (V+), IC10.8 (V+); also elsewhere on the board
+5VA: C8.+, C15.2, C32.2, C76.2, C90.2, C110.2, IC5.8 (V+), IC11.8 (V+), IC13.8 (V+), IC16.8 (V+), R132.2, R133.2, U8.8 (VDD); also elsewhere on the board
AGND: C8.-, C15.1, C16.2, C22.1, C26.1, C32.1, C36.2, C42.1, C76.1, C82.-, C85.1, C86.1, C90.1, C93.2, C94.2, C108.1, C109.1, C110.1, C171.1, C175.1, C176.1, C177.1, C178.1, C209.1, C212.1, C215.1, C219.1, C224.1, IC4.4 (V-), IC5.4 (V-), IC10.4 (V-), IC11.4 (V-), IC13.4 (V-), IC16.3 (IN+), IC16.4 (V-), IC16.5 (IN+), IC16.6 (IN-), LED3.C, R85.1, R86.1, R93.2, R127.1, R128.1, R174.2, R175.2, R181.2, R186.2, U8.4 (GND), U8.5 (SD); also elsewhere on the board
HPL: IC5.5 (IN+); also elsewhere on the board
HPL-J: C9.-; also elsewhere on the board
HPL^: P2.4; also elsewhere on the board
HPR: IC5.3 (IN+); also elsewhere on the board
HPR-J: C7.-; also elsewhere on the board
HPR^: P2.1; also elsewhere on the board
IN-VREF: IC13.1 (OUT), IC13.2 (IN-); also elsewhere on the board
unnamed: C45.+, P3.6
unnamed: C46.+, P3.5
unnamed: C100.-, P3.1
unnamed: C101.+, IC11.5 (IN+)
unnamed: C178.2, R81.2, R89.1, R90.2
unnamed: C93.1, R96.1, R97.1, R111.1
unnamed: C85.2, IC10.3 (IN+), R97.2
unnamed: C72.2, IC10.1 (OUT), R81.1, R82.1
unnamed: C65.+, C177.2, R82.2
unnamed: C175.2, R84.2, R91.2, R92.1
unnamed: C72.1, IC10.2 (IN-), R90.1
unnamed: C94.1, R98.1, R99.1, R112.1
unnamed: C86.2, IC10.5 (IN+), R98.2
unnamed: C73.2, IC10.7 (OUT), R83.1, R84.1
unnamed: C66.+, C176.2, R83.2
unnamed: C73.1, IC10.6 (IN-), R91.1
unnamed: C209.2, R51.2, R52.2, R70.1
unnamed: C36.1, R53.1, R54.1, R71.1
unnamed: C42.2, IC4.3 (IN+), R53.2
unnamed: C41.2, IC4.1 (OUT), R44.1, R51.1
unnamed: C35.+, C212.2, R44.2
unnamed: C41.1, IC4.2 (IN-), R52.1
unnamed: C224.2, R21.1, R29.2, R31.2
unnamed: C16.1, R22.1, R30.1, R36.1
unnamed: C22.2, IC4.5 (IN+), R30.2
unnamed: C75.+, C88.2, IC11.7 (OUT), R104.2
unnamed: C88.1, IC11.6 (IN-), R104.1, R113.2
unnamed: C101.-, P3.4
unnamed: C21.2, IC4.7 (OUT), R31.1, R39.1
unnamed: C100.+, IC11.3 (IN+)
unnamed: C25.+, C219.2, R39.2
unnamed: C21.1, IC4.6 (IN-), R29.1
unnamed: C74.+, C87.2, IC11.1 (OUT), R101.2
unnamed: C87.1, IC11.2 (IN-), R101.1, R114.2
unnamed: C26.2, U8.3 (BYP)
unnamed: C31.2, IC5.1 (OUT), IC5.2 (IN-)
unnamed: C33.2, IC5.6 (IN-), IC5.7 (OUT)
unnamed: C33.1, R35.2
unnamed: C31.1, R32.1
unnamed: R32.2, R33.1, U8.2 (INA-)
unnamed: C7.+, R33.2, U8.1 (OUTA)
unnamed: C43.1, P2.5
unnamed: R34.2, R35.1, U8.6 (INB-)
unnamed: C44.1, P2.6
unnamed: C109.2, IC13.3 (IN+), R128.2, R133.1
unnamed: C9.+, R34.1, U8.7 (OUTB)
unnamed: C108.2, IC13.5 (IN+), R127.2, R132.1
unnamed: D10.A, IC16.2 (IN-), R87.1, R88.1, R119.2
unnamed: D7.A, D10.C, IC16.1 (OUT), R119.1
unnamed: D7.C, R105.2
unnamed: C82.+, R56.1, R93.1, R105.1
unnamed: LED3.A, R56.2
OUT1L: C66.-, R174.1; also elsewhere on the board
OUT1L+: R99.2; also elsewhere on the board
OUT1L-: R92.2; also elsewhere on the board
OUT1L-J^: C75.-, R86.2, R87.2; also elsewhere on the board
OUT1L^: C43.2, C46.-; also elsewhere on the board
OUT1R: C65.-, R175.1; also elsewhere on the board
OUT1R+: R96.2; also elsewhere on the board
OUT1R-: R89.2; also elsewhere on the board
OUT1R-J^: C74.-, R85.2, R88.2; also elsewhere on the board
OUT1R^: C44.2, C45.-; also elsewhere on the board
OUT2-L: C25.-, R186.1; also elsewhere on the board
OUT2-R: C35.-, R181.1; also elsewhere on the board
OUT2L+: R22.2; also elsewhere on the board
OUT2L-: R21.2; also elsewhere on the board
OUT2R+: R71.2; also elsewhere on the board
OUT2R-: R70.2; also elsewhere on the board
OUT-VREF: IC13.6 (IN-), IC13.7 (OUT), P2.2, P2.3, P3.2, P3.3, R113.1, R114.1
VREF: R36.2, R54.2, R111.2, R112.2; also elsewhere on the board

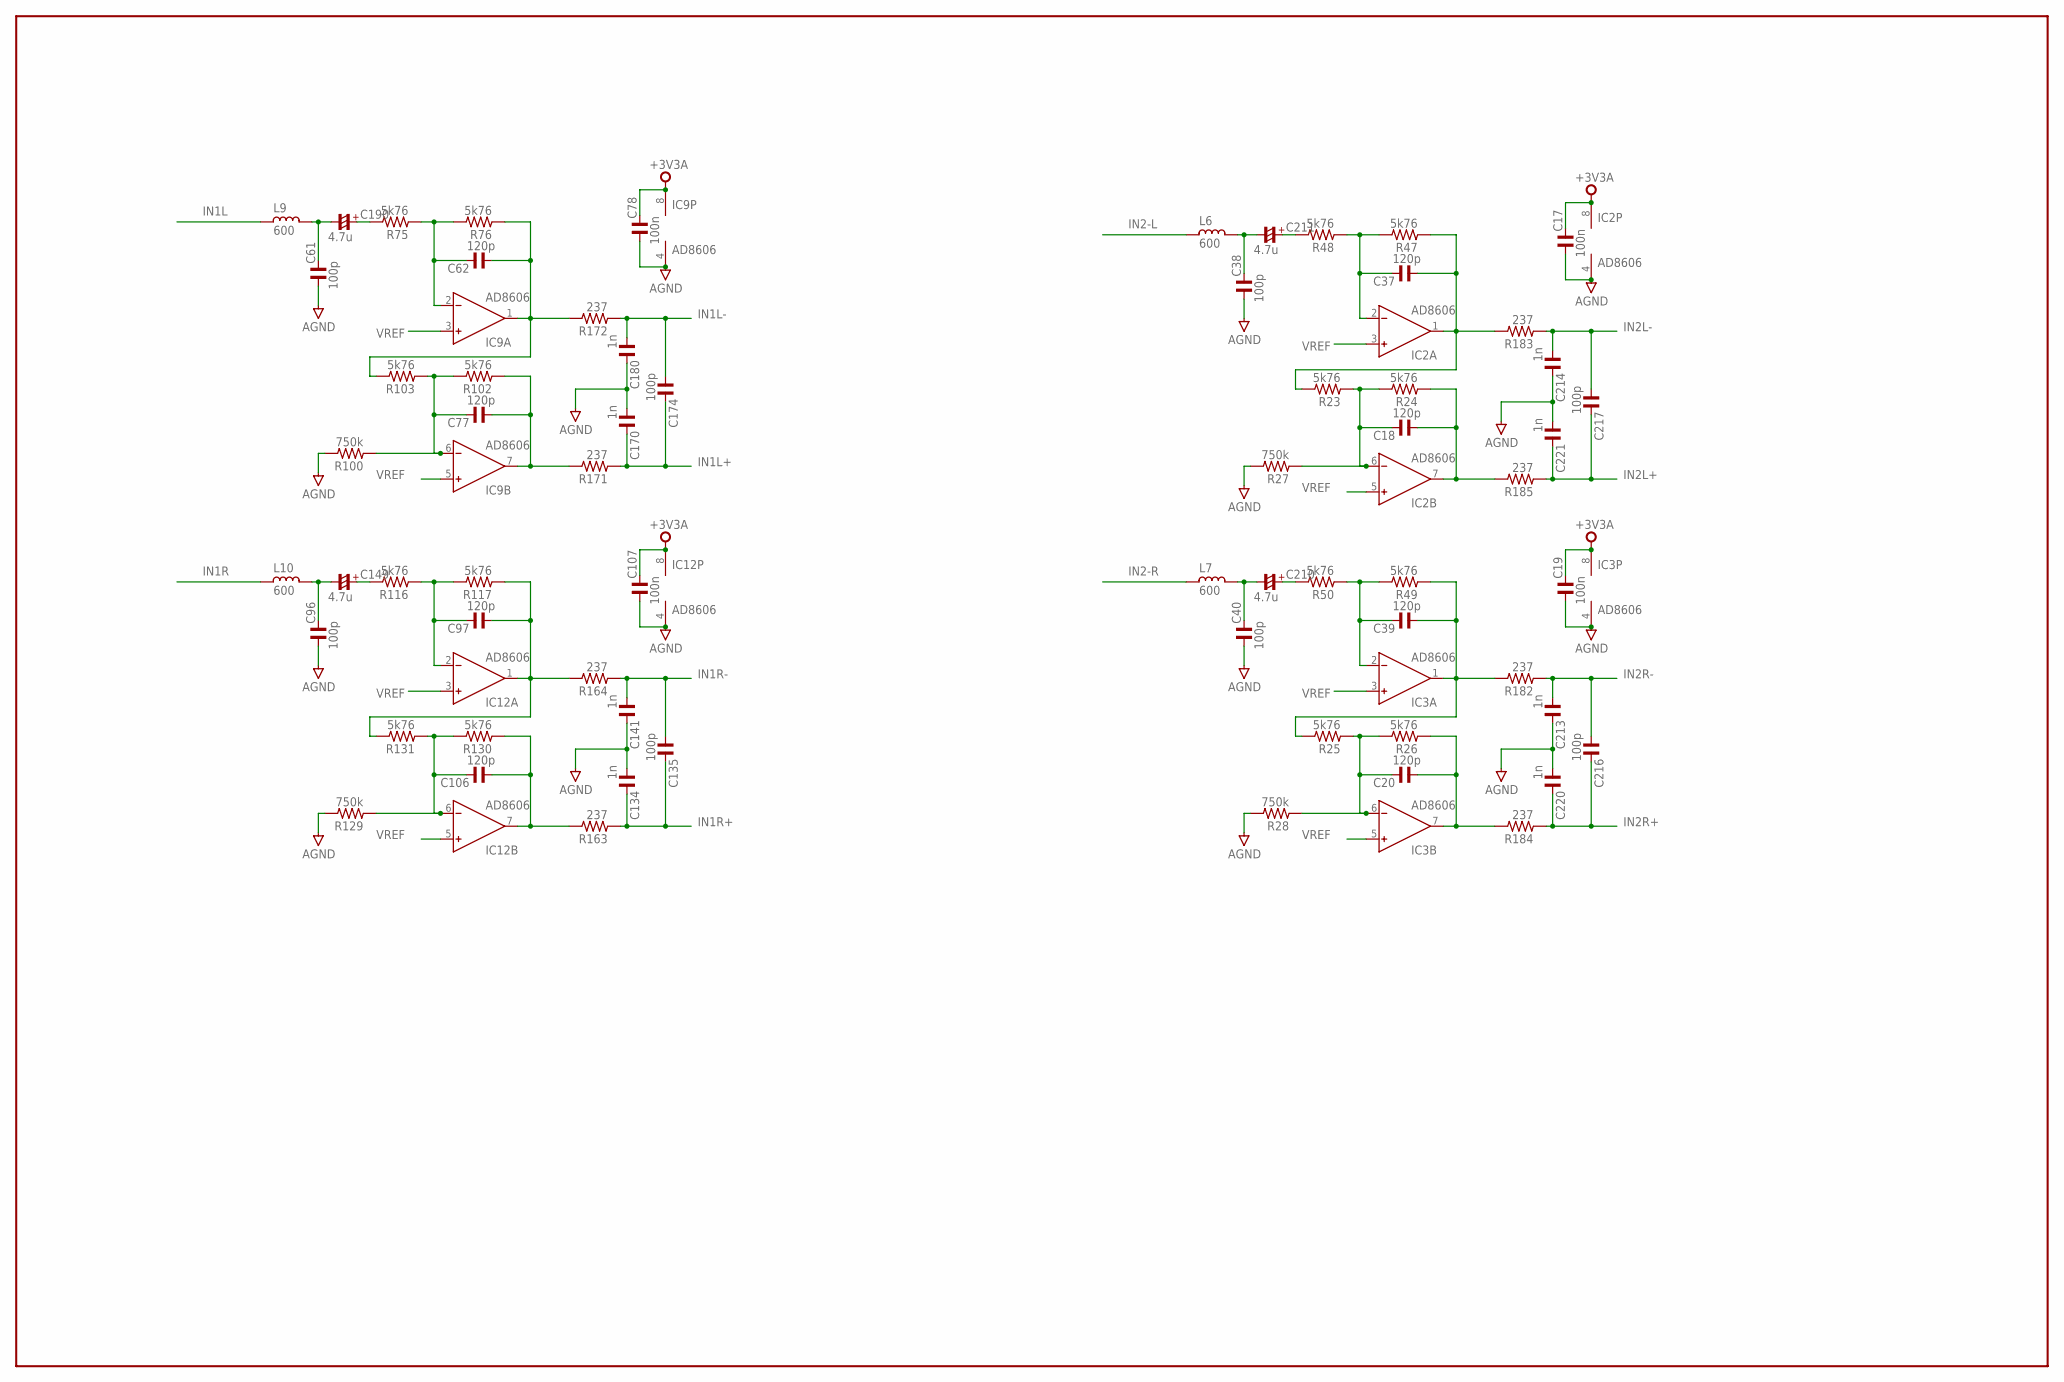
[picture p17: schematic aleph.sch, sheet 8]

Parts:
C17, C19, C78, C107: 100n; C0603
C18, C20, C37, C39, C62, C77, C97, C106: 120p; C0603
C38, C40, C61, C96, C135, C174, C216, C217: 100p; C0603
C134, C141, C170, C180, C213, C214, C220, C221: 1n; C0603
C149, C190, C210, C211: 4.7u; C1206/T
IC2, IC3, IC9, IC12: AD8606; SO8
L6, L7, L9, L10: 600; L0603
R23, R24, R25, R26, R47, R48, R49, R50, R75, R76, R102, R103, R116, R117, R130, R131: 5k76; R0603
R27, R28, R100, R129: 750k; R0603
R163, R164, R171, R172, R182, R183, R184, R185: 237; R0603

Connections:
+3V3A: C17.2, C19.2, C78.2, C107.2, IC2.8 (V+), IC3.8 (V+), IC9.8 (V+), IC12.8 (V+); also elsewhere on the board
AGND: C17.1, C19.1, C38.1, C40.1, C61.1, C78.1, C96.1, C107.1, C134.1, C141.2, C170.1, C180.2, C213.2, C214.2, C220.1, C221.1, IC2.4 (V-), IC3.4 (V-), IC9.4 (V-), IC12.4 (V-), R27.2, R28.2, R100.2, R129.2; also elsewhere on the board
IN1L: L9.2; also elsewhere on the board
IN1L+: C170.2, C174.2, R171.1; also elsewhere on the board
IN1L-: C174.1, C180.1, R172.1; also elsewhere on the board
IN1R: L10.2; also elsewhere on the board
IN1R+: C134.2, C135.2, R163.1; also elsewhere on the board
IN1R-: C135.1, C141.1, R164.1; also elsewhere on the board
IN2-L: L6.2; also elsewhere on the board
IN2-R: L7.2; also elsewhere on the board
IN2L+: C217.2, C221.2, R185.1; also elsewhere on the board
IN2L-: C214.1, C217.1, R183.1; also elsewhere on the board
IN2R+: C216.2, C220.2, R184.1; also elsewhere on the board
IN2R-: C213.1, C216.1, R182.1; also elsewhere on the board
unnamed: C190.+, R75.2
unnamed: C97.1, IC12.1 (OUT), R117.1, R131.2, R164.2
unnamed: C106.1, IC12.7 (OUT), R130.1, R163.2
unnamed: C96.2, C149.-, L10.1
unnamed: C97.2, IC12.2 (IN-), R116.1, R117.2
unnamed: C106.2, IC12.6 (IN-), R129.1, R130.2, R131.1
unnamed: C149.+, R116.2
unnamed: C62.1, IC9.1 (OUT), R76.1, R103.2, R172.2
unnamed: C77.1, IC9.7 (OUT), R102.1, R171.2
unnamed: C61.2, C190.-, L9.1
unnamed: C62.2, IC9.2 (IN-), R75.1, R76.2
unnamed: C77.2, IC9.6 (IN-), R100.1, R102.2, R103.1
unnamed: C37.1, IC2.1 (OUT), R23.2, R47.1, R183.2
unnamed: C18.1, IC2.7 (OUT), R24.1, R185.2
unnamed: C38.2, C211.-, L6.1
unnamed: C37.2, IC2.2 (IN-), R47.2, R48.1
unnamed: C18.2, IC2.6 (IN-), R23.1, R24.2, R27.1
unnamed: C211.+, R48.2
unnamed: C39.1, IC3.1 (OUT), R25.2, R49.1, R182.2
unnamed: C20.1, IC3.7 (OUT), R26.1, R184.2
unnamed: C40.2, C210.-, L7.1
unnamed: C39.2, IC3.2 (IN-), R49.2, R50.1
unnamed: C20.2, IC3.6 (IN-), R25.1, R26.2, R28.1
unnamed: C210.+, R50.2
VREF: IC2.3 (IN+), IC2.5 (IN+), IC3.3 (IN+), IC3.5 (IN+), IC9.3 (IN+), IC9.5 (IN+), IC12.3 (IN+), IC12.5 (IN+); also elsewhere on the board

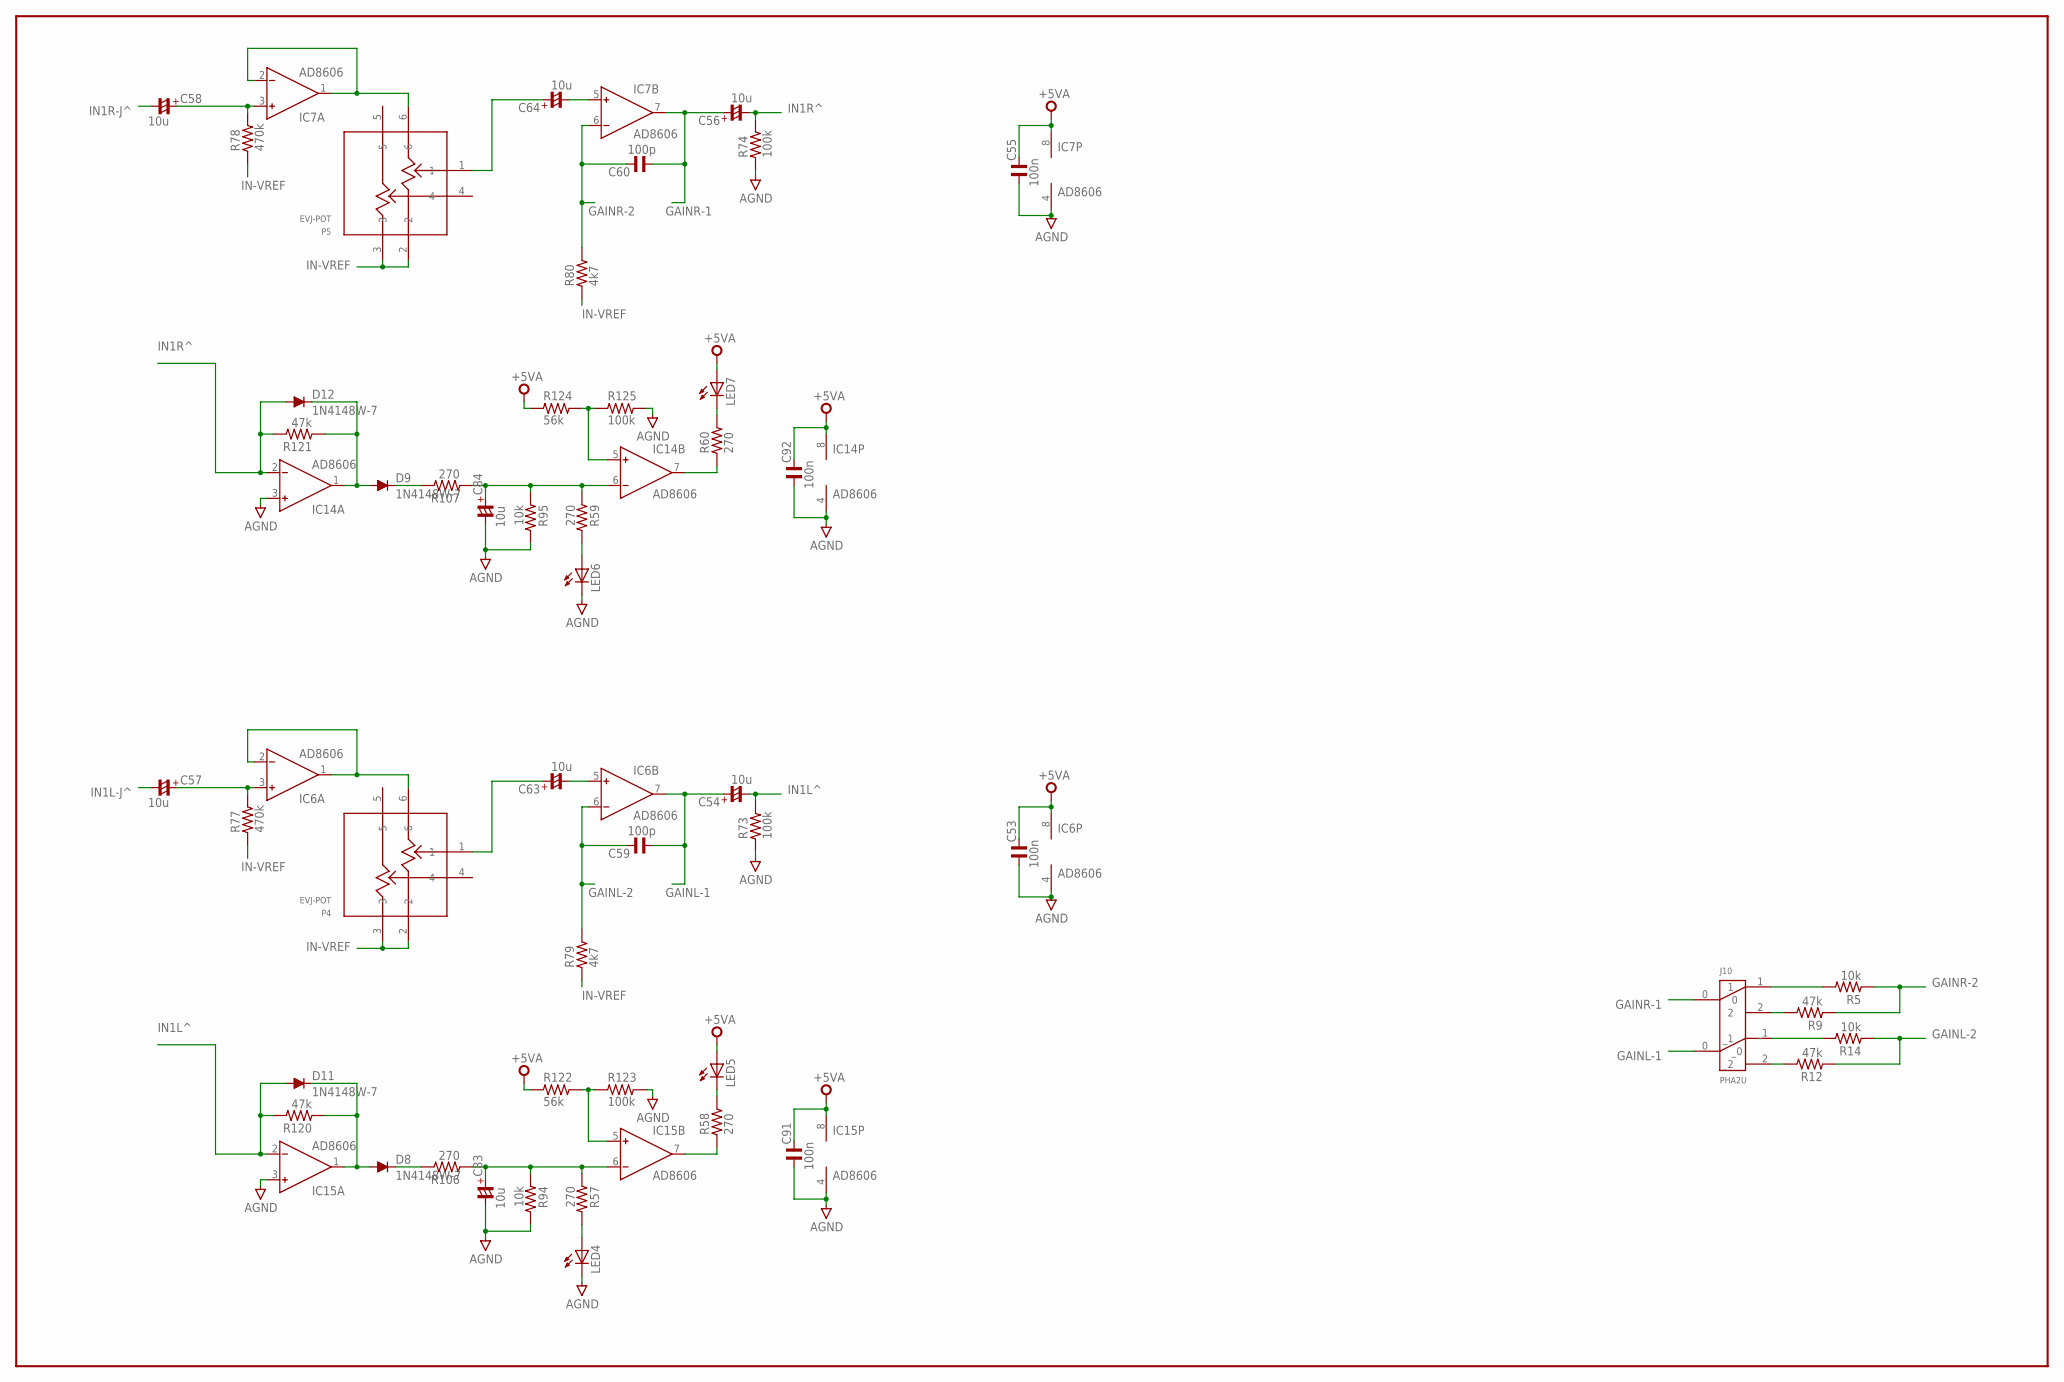
[picture p18: schematic aleph.sch, sheet 9]

Parts:
C53, C55, C91, C92: 100n; C0603
C54, C56, C57, C58, C63, C64, C83, C84: 10u; C1206/T
C59, C60: 100p; C0603
D8, D9, D11, D12: 1N4148W-7; SOD123
IC6, IC7, IC14, IC15: AD8606; SO8
J10: PHA2U
LED4, LED5, LED6, LED7: LEDCHIPLED_0805; CHIPLED_0805
P4, P5: EVJ-POT
R5, R14, R94, R95: 10k; R0603
R9, R12, R120, R121: 47k; R0603
R57, R58, R59, R60, R106, R107: 270; R0603
R73, R74, R123, R125: 100k; R0603
R77, R78: 470k; R0603
R79, R80: 4k7; R0603
R122, R124: 56k; R0603

Connections:
+5VA: C53.2, C55.2, C91.2, C92.2, IC6.8 (V+), IC7.8 (V+), IC14.8 (V+), IC15.8 (V+), LED5.A, LED7.A, R122.1, R124.1; also elsewhere on the board
AGND: C53.1, C55.1, C83.-, C84.-, C91.1, C92.1, IC6.4 (V-), IC7.4 (V-), IC14.3 (IN+), IC14.4 (V-), IC15.3 (IN+), IC15.4 (V-), LED4.C, LED6.C, R73.1, R74.1, R94.2, R95.2, R123.2, R125.2; also elsewhere on the board
GAINL-1: C54.+, C59.1, IC6.7 (OUT), J10._0
GAINL-2: C59.2, IC6.6 (IN-), R12.1, R14.1, R79.2
GAINR-1: C56.+, C60.1, IC7.7 (OUT), J10.0
GAINR-2: C60.2, IC7.6 (IN-), R5.1, R9.1, R80.2
IN1L-J^: C57.-; also elsewhere on the board
IN1L^: C54.-, D11.A, IC15.2 (IN-), R73.2, R120.2; also elsewhere on the board
IN1R-J^: C58.-; also elsewhere on the board
IN1R^: C56.-, D12.A, IC14.2 (IN-), R74.2, R121.2; also elsewhere on the board
IN-VREF: P4.2, P4.3, P5.2, P5.3, R77.1, R78.1, R79.1, R80.1; also elsewhere on the board
unnamed: C57.+, IC6.3 (IN+), R77.2
unnamed: IC6.1 (OUT), IC6.2 (IN-), P4.6
unnamed: C63.-, IC6.5 (IN+)
unnamed: D8.A, D11.C, IC15.1 (OUT), R120.1
unnamed: LED7.C, R60.2
unnamed: C63.+, P4.1
unnamed: D8.C, R106.2
unnamed: C83.+, IC15.6 (IN-), R57.1, R94.1, R106.1
unnamed: LED5.C, R58.2
unnamed: C58.+, IC7.3 (IN+), R78.2
unnamed: J10._2, R12.2
unnamed: IC7.1 (OUT), IC7.2 (IN-), P5.6
unnamed: LED4.A, R57.2
unnamed: J10._1, R14.2
unnamed: J10.2, R9.2
unnamed: J10.1, R5.2
unnamed: IC15.7 (OUT), R58.1
unnamed: IC15.5 (IN+), R122.2, R123.1
unnamed: C64.-, IC7.5 (IN+)
unnamed: C64.+, P5.1
unnamed: D9.A, D12.C, IC14.1 (OUT), R121.1
unnamed: D9.C, R107.2
unnamed: C84.+, IC14.6 (IN-), R59.1, R95.1, R107.1
unnamed: LED6.A, R59.2
unnamed: IC14.7 (OUT), R60.1
unnamed: IC14.5 (IN+), R124.2, R125.1

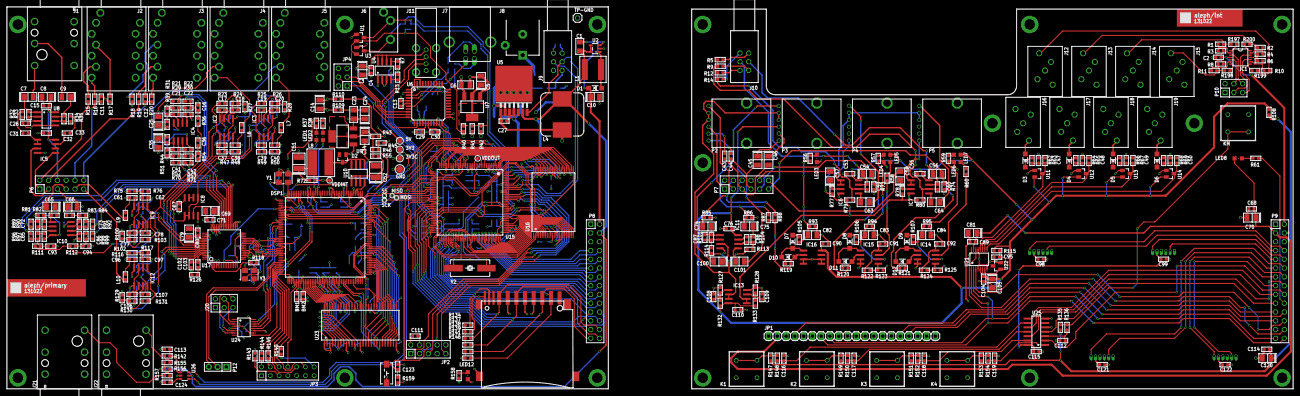
[picture p19: board aleph.brd from above]

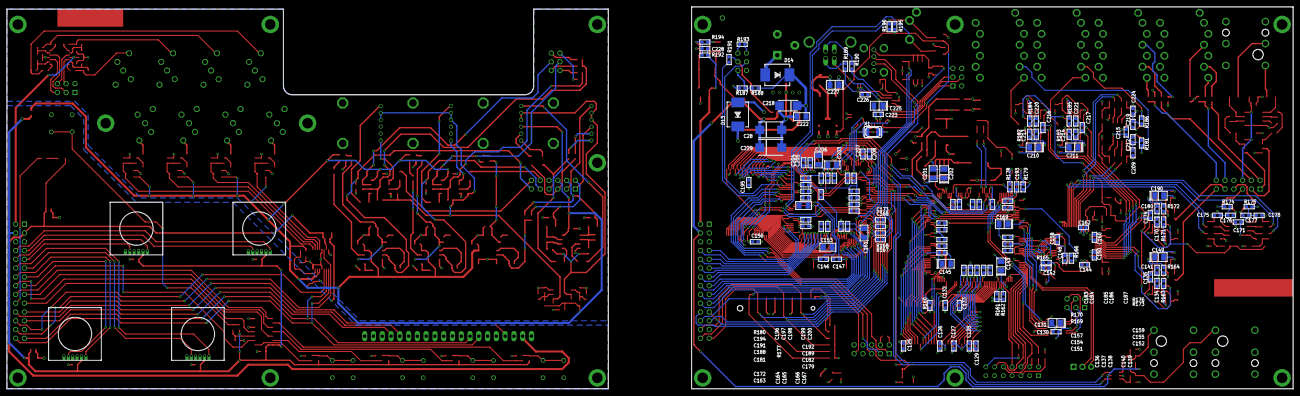
[picture p20: board aleph.brd from below]

Board: 4 copper layers, 372.1 x 110.5 mm, 575 parts (150 on the bottom side), 447 nets.
