monome/aleph-hardware/(notices)

Notices in the files:
parts and their libraries:
atmel-avr: Copyright (C) 2008, Bob Starr
